MadsRudolph/curtain-drive/enclosure/showcase/drive-motion-poster.png

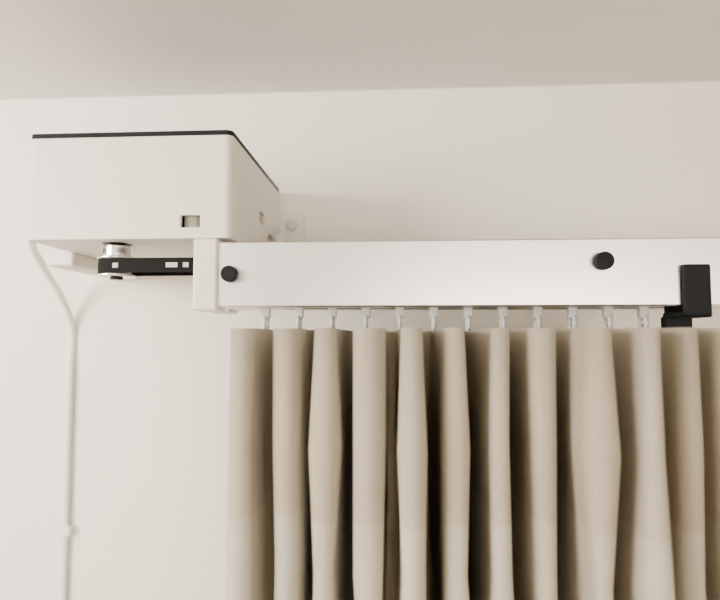
enclosure/showcase/drive-motion-poster.png
