MadsRudolph/curtain-drive/enclosure/showcase/curtains-motion-poster.png

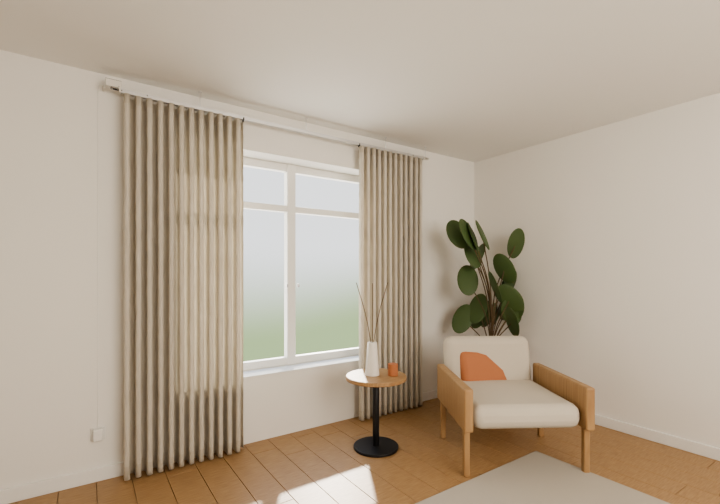
enclosure/showcase/curtains-motion-poster.png
