MadsRudolph/curtain-drive/enclosure/pulley/renders/clamp.png

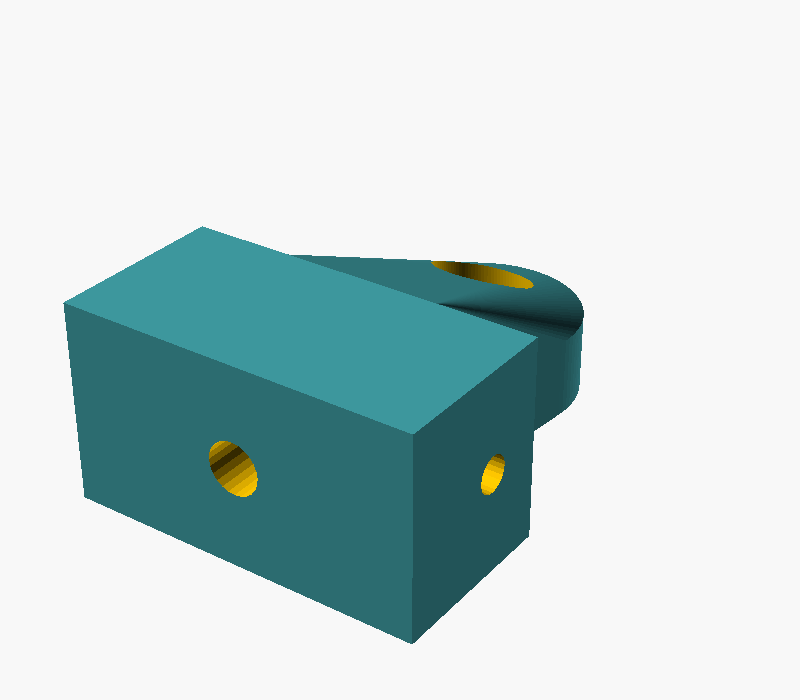
enclosure/pulley/renders/clamp.png
