MadsRudolph/curtain-drive/enclosure/pulley/renders/drum.png

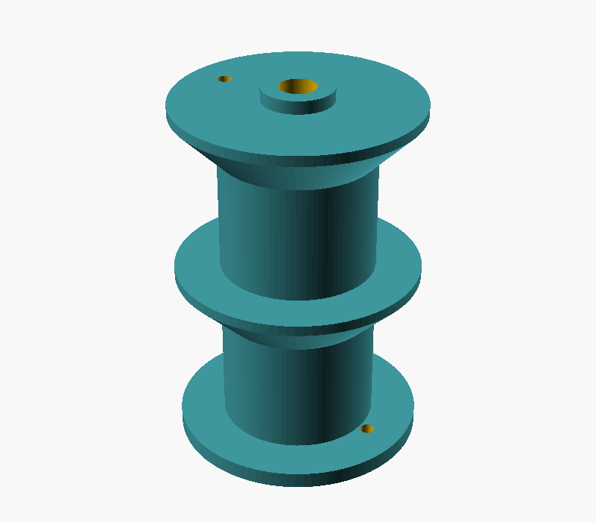
enclosure/pulley/renders/drum.png
