MadsRudolph/curtain-drive/enclosure/pulley/renders/drum_section.png

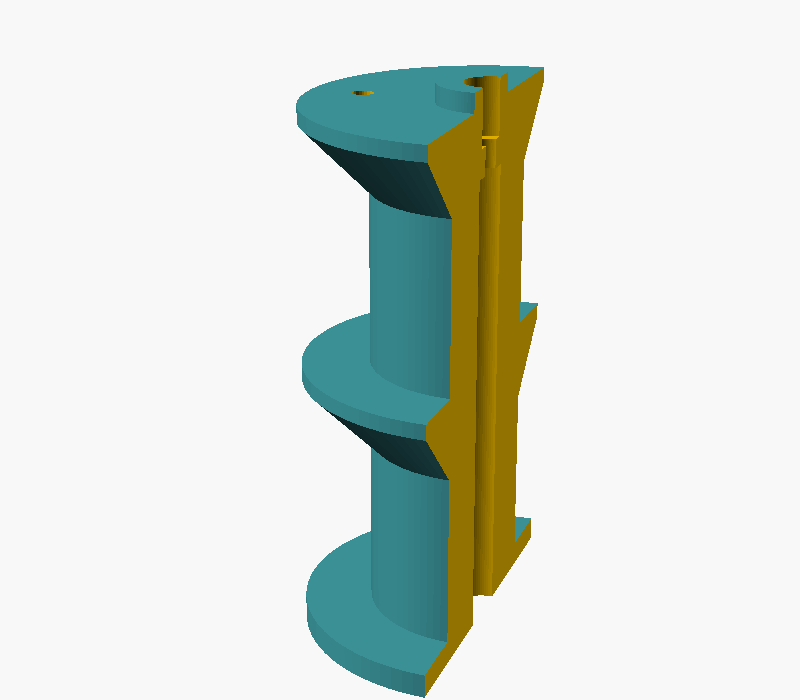
enclosure/pulley/renders/drum_section.png
