MadsRudolph/curtain-drive/enclosure/pulley/renders/idler_bracket.png

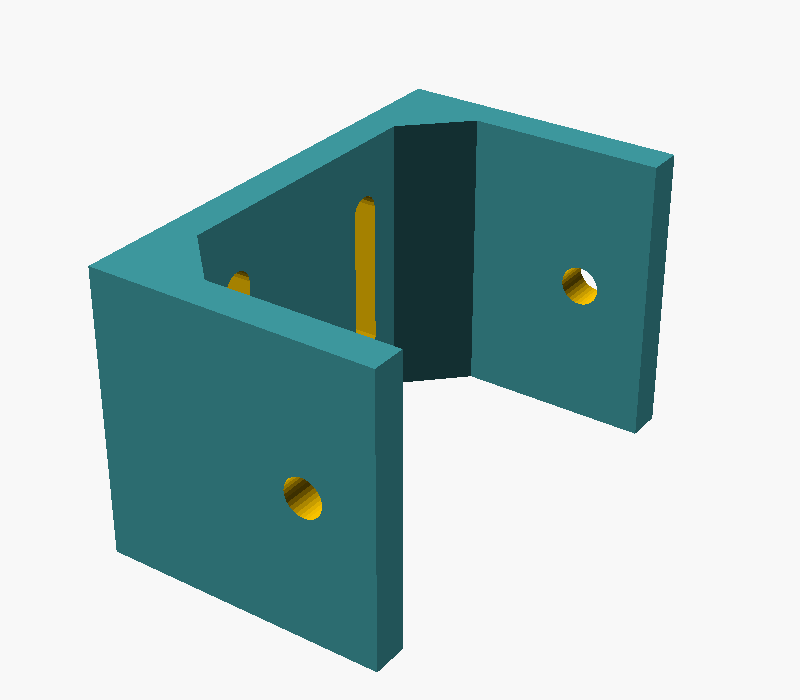
enclosure/pulley/renders/idler_bracket.png
