MadsRudolph/curtain-drive/enclosure/pulley/renders/overview.png

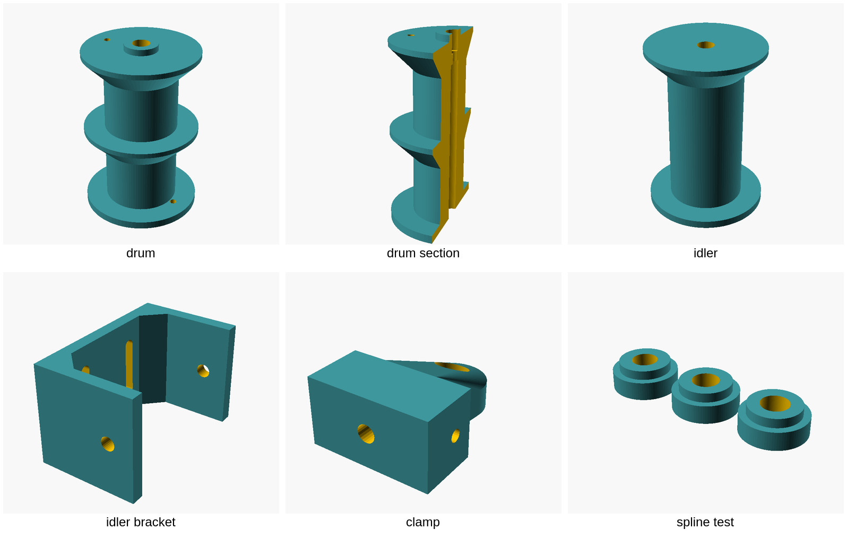
enclosure/pulley/renders/overview.png
