MadsRudolph/curtain-drive/enclosure/pulley/renders/plate_xl.png

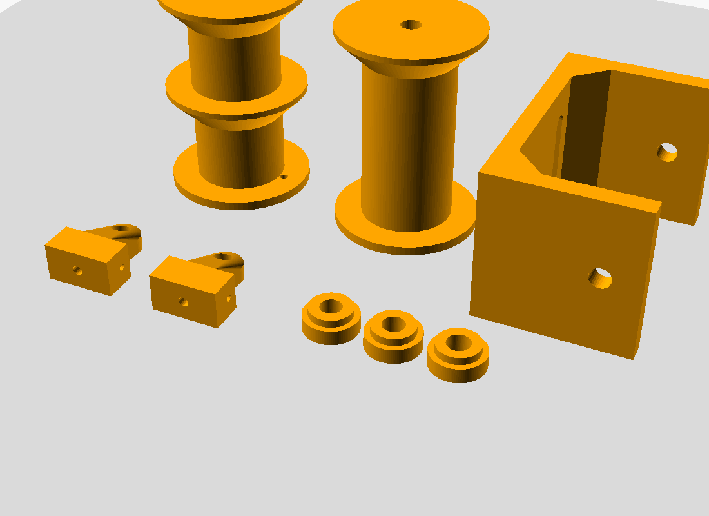
enclosure/pulley/renders/plate_xl.png
