MadsRudolph/curtain-drive/enclosure/renders/base_bottom.png

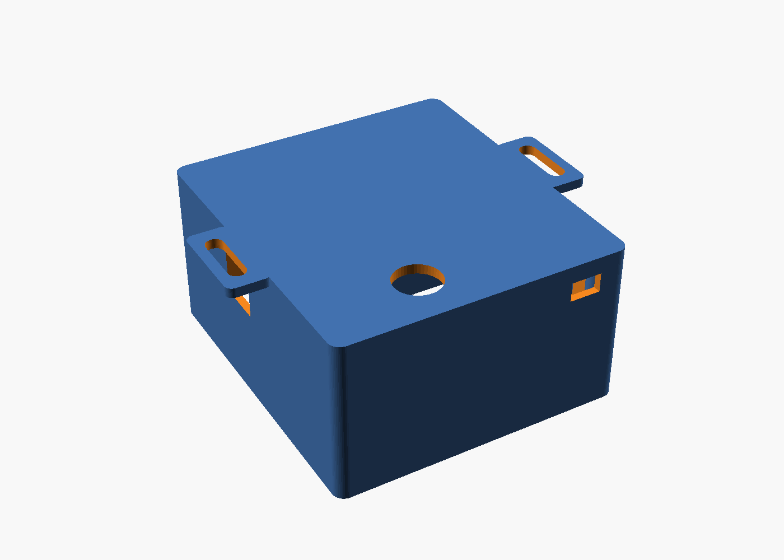
enclosure/renders/base_bottom.png
