MadsRudolph/curtain-drive/enclosure/renders/base_top.png

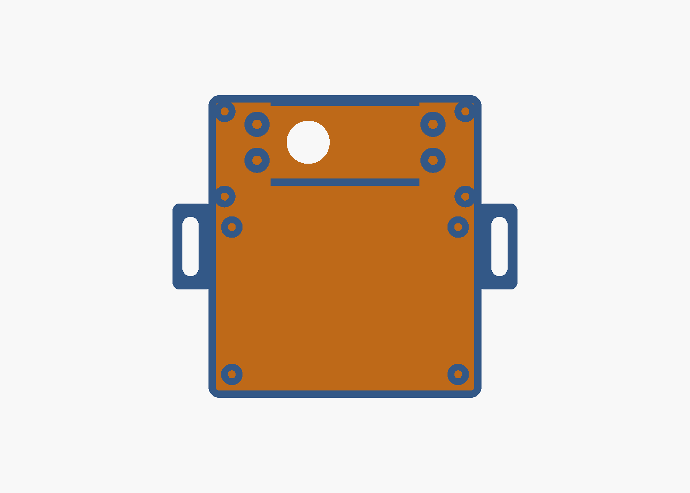
enclosure/renders/base_top.png
