MadsRudolph/curtain-drive/enclosure/renders/blender_closed.png

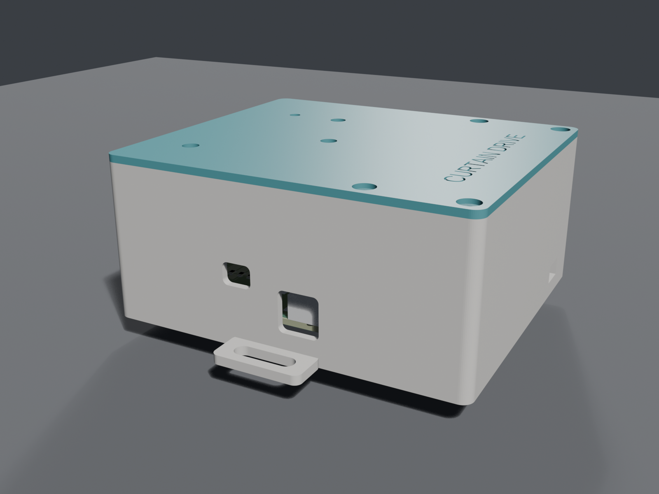
enclosure/renders/blender_closed.png
