MadsRudolph/curtain-drive/enclosure/renders/blender_open.png

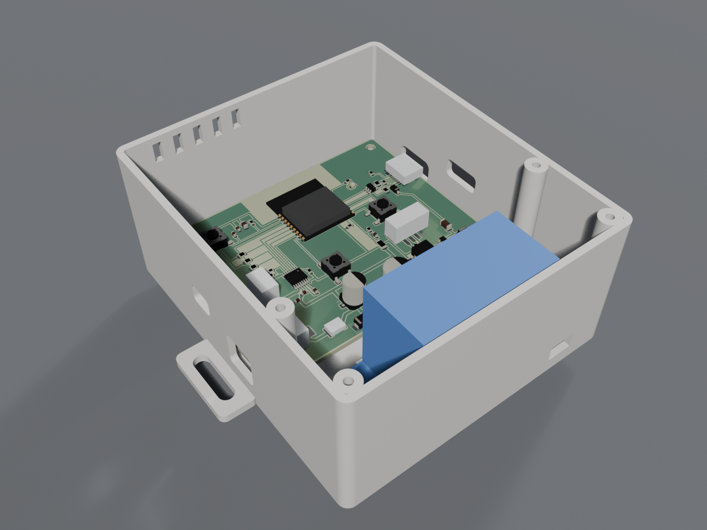
enclosure/renders/blender_open.png
