MadsRudolph/curtain-drive/enclosure/renders/lid.png

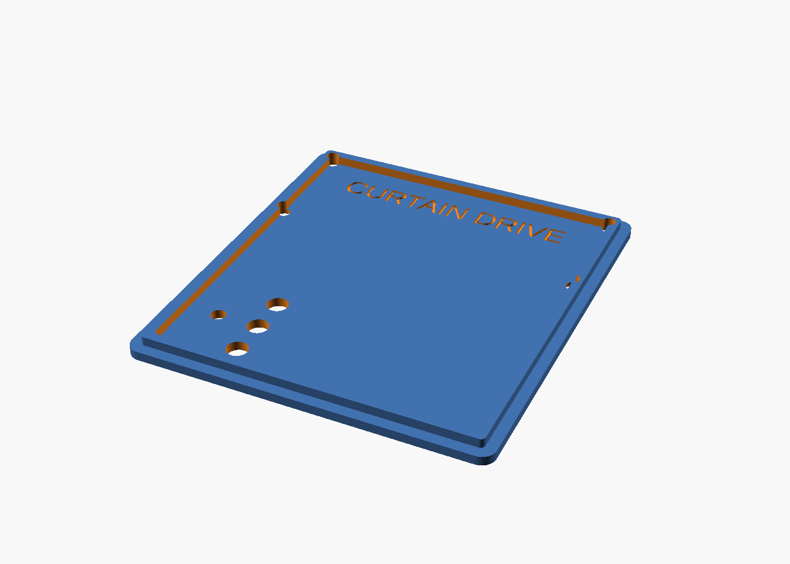
enclosure/renders/lid.png
