MadsRudolph/curtain-drive/enclosure/renders/pcb_iso.png

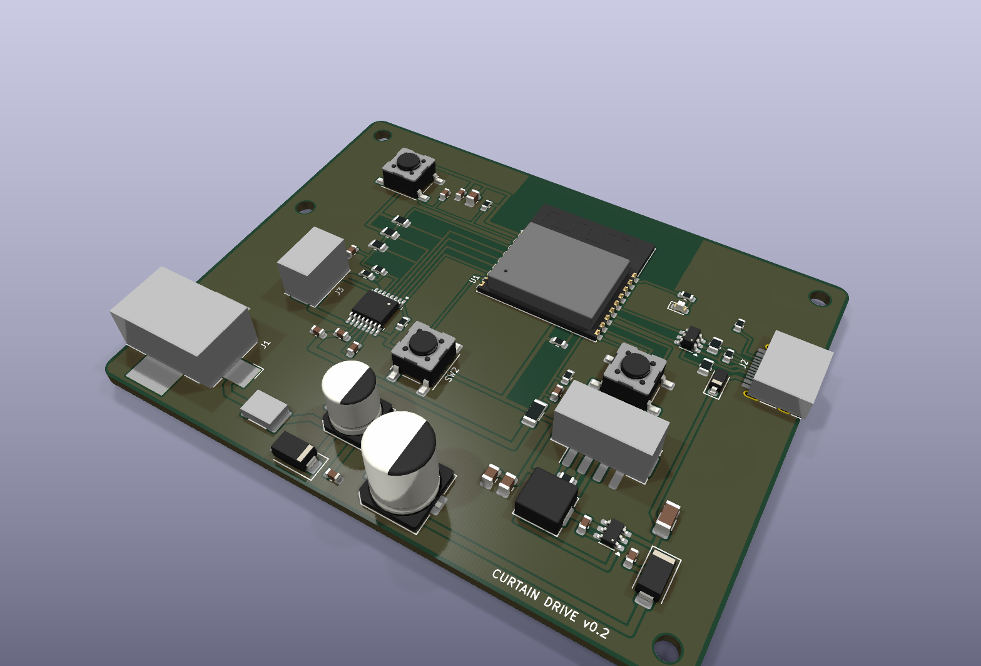
enclosure/renders/pcb_iso.png
