MadsRudolph/curtain-drive/enclosure/renders/pcb_revB_bottom.png

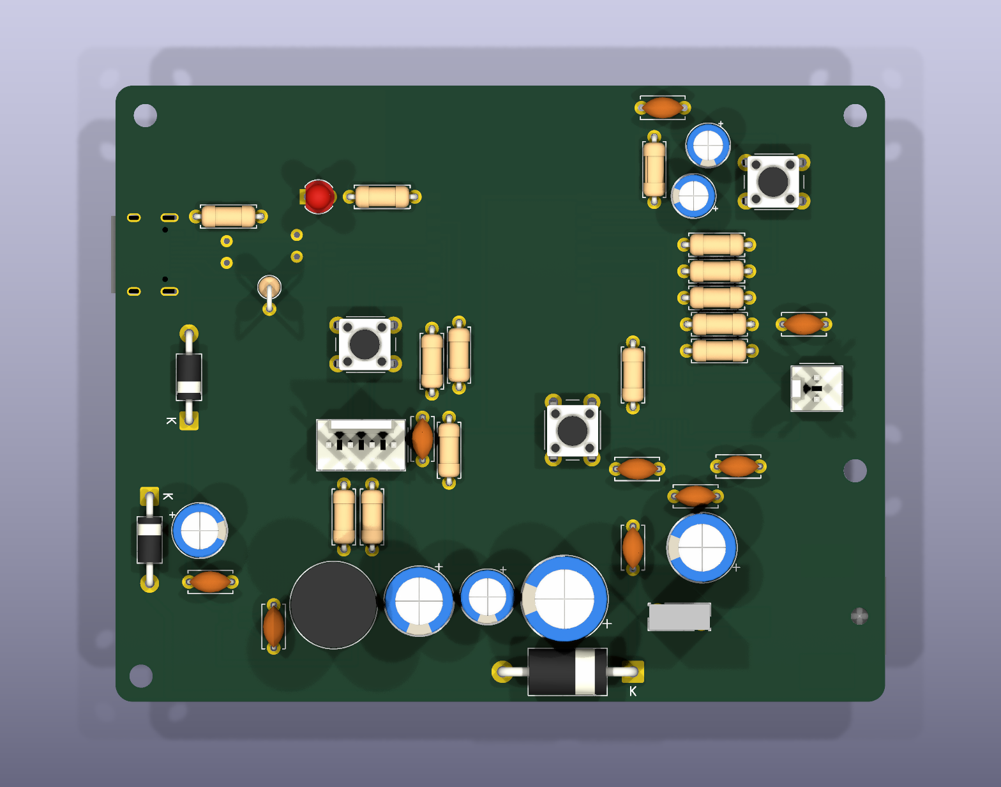
enclosure/renders/pcb_revB_bottom.png
