MadsRudolph/curtain-drive/enclosure/renders/pcb_revB_bottom_iso.png

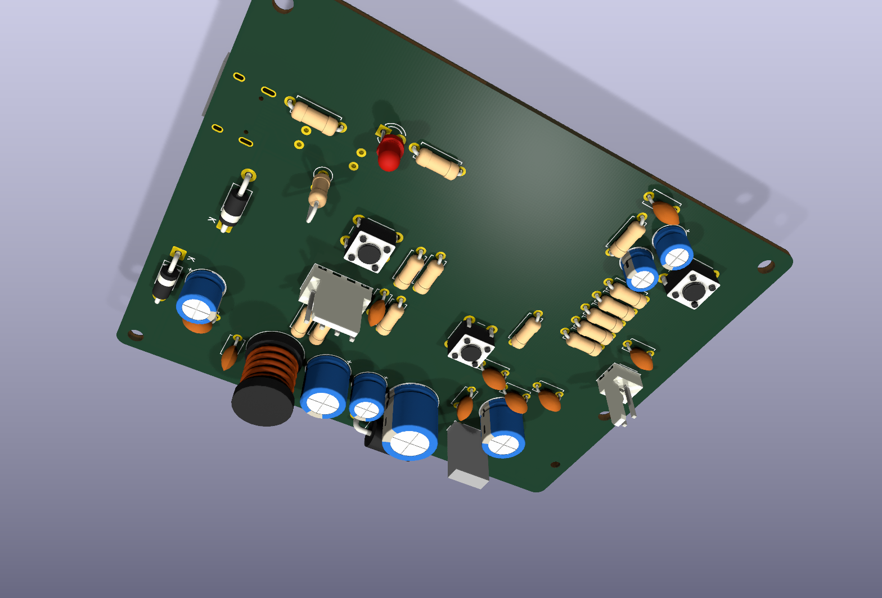
enclosure/renders/pcb_revB_bottom_iso.png
