MadsRudolph/curtain-drive/enclosure/renders/pcb_revB_iso.png

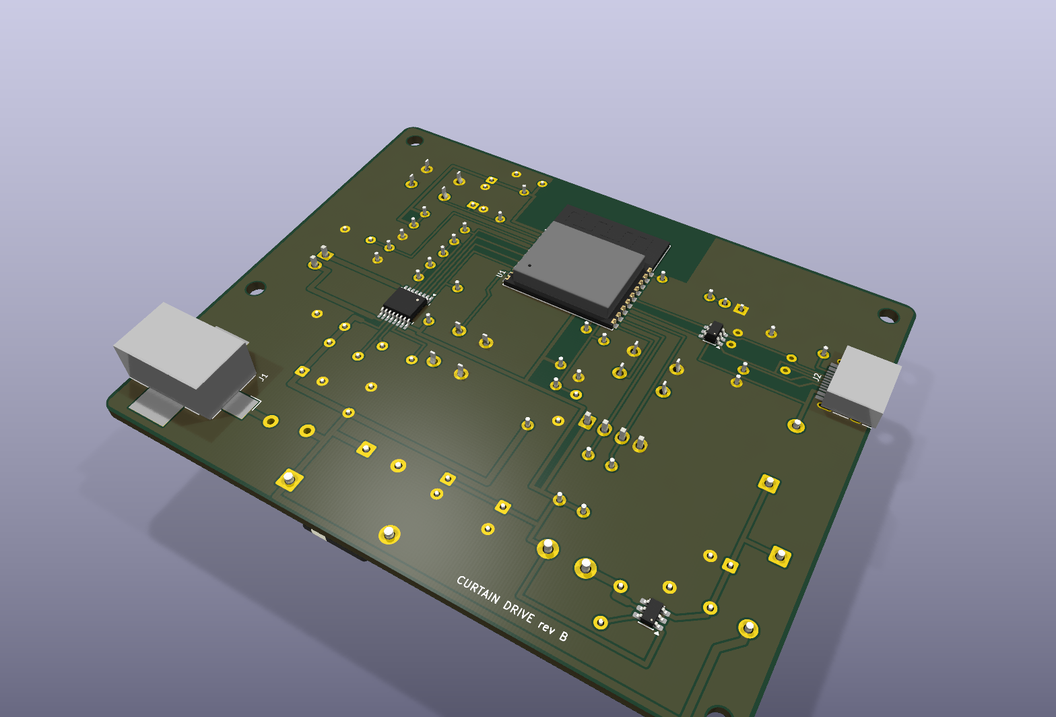
enclosure/renders/pcb_revB_iso.png
