MadsRudolph/curtain-drive/enclosure/renders/pcb_revB_top.png

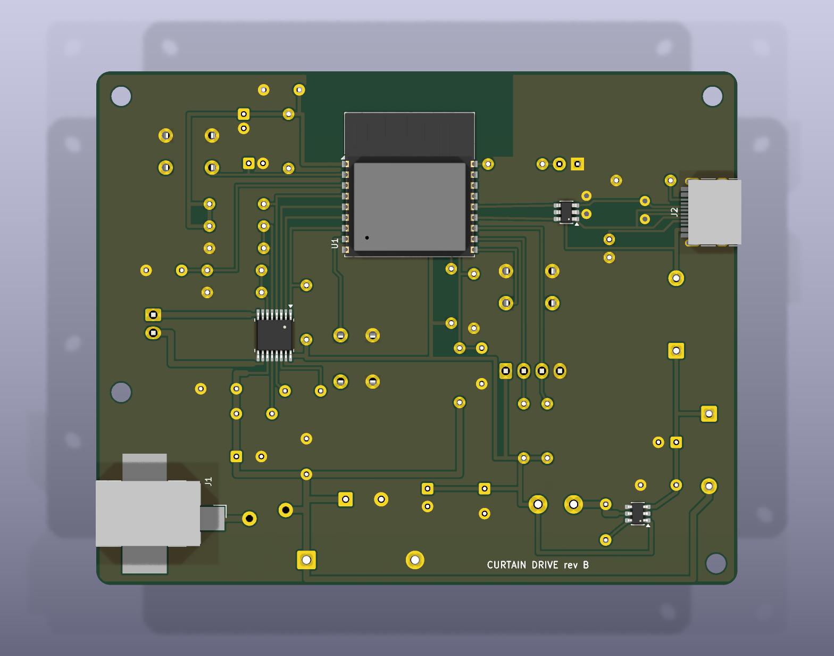
enclosure/renders/pcb_revB_top.png
