MadsRudolph/curtain-drive/enclosure/renders/pcb_top.png

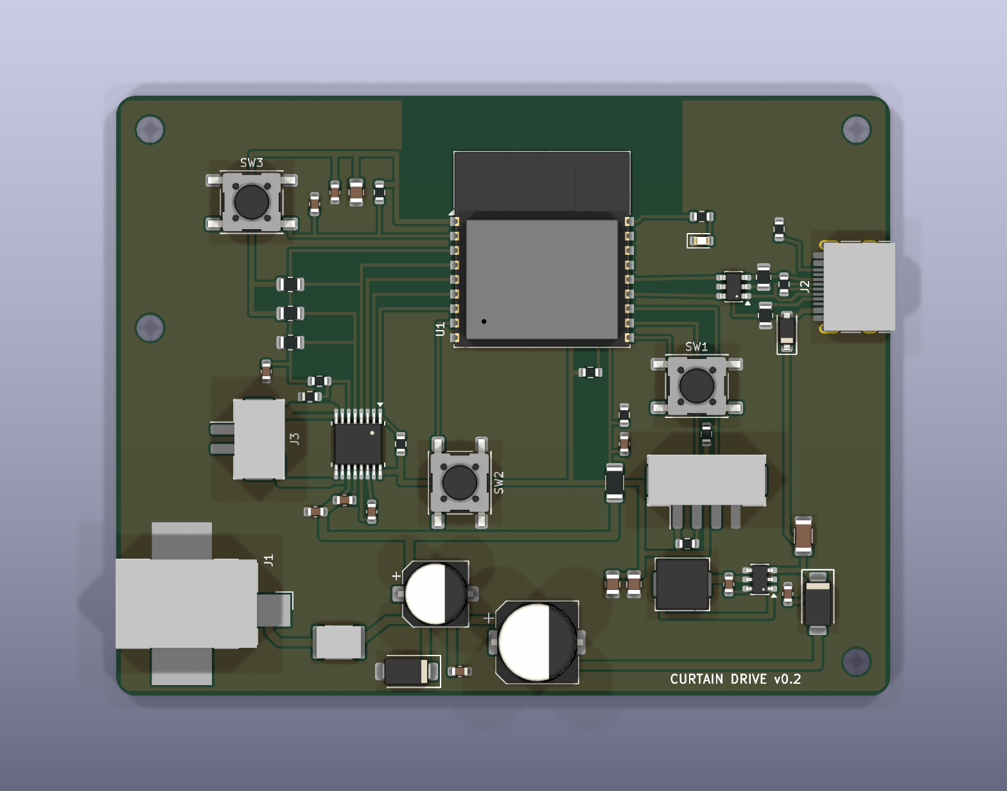
enclosure/renders/pcb_top.png
