MadsRudolph/curtain-drive/enclosure/renders/revC_closed.png

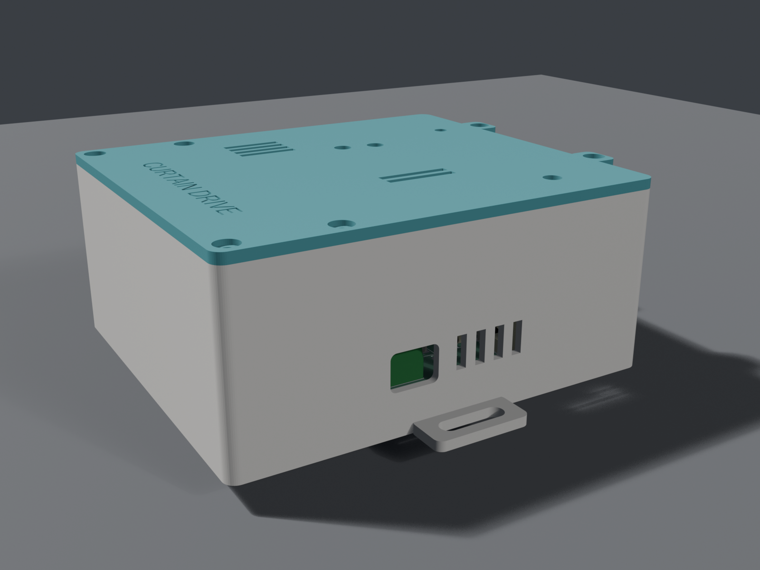
enclosure/renders/revC_closed.png
