MadsRudolph/curtain-drive/enclosure/renders/revC_lid_underside.png

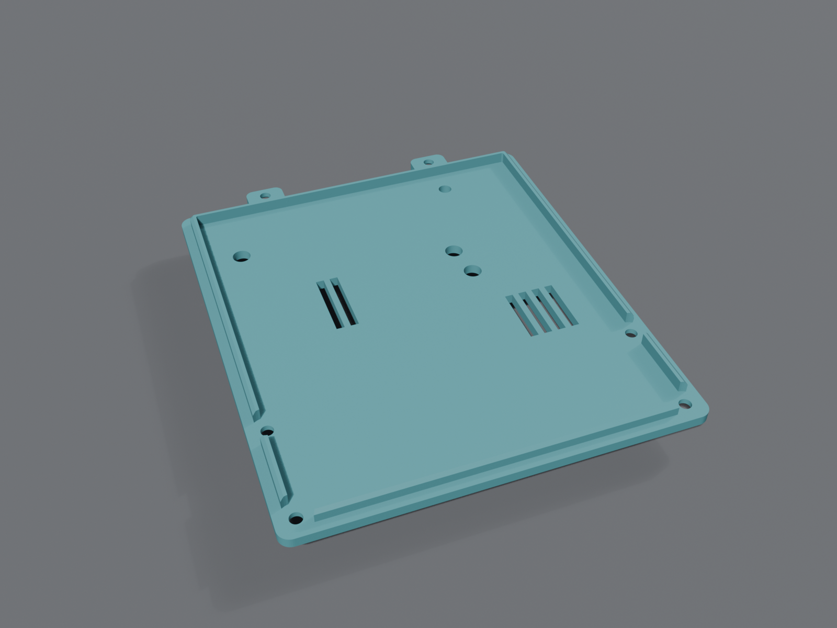
enclosure/renders/revC_lid_underside.png
