MadsRudolph/curtain-drive/enclosure/renders/revC_open.png

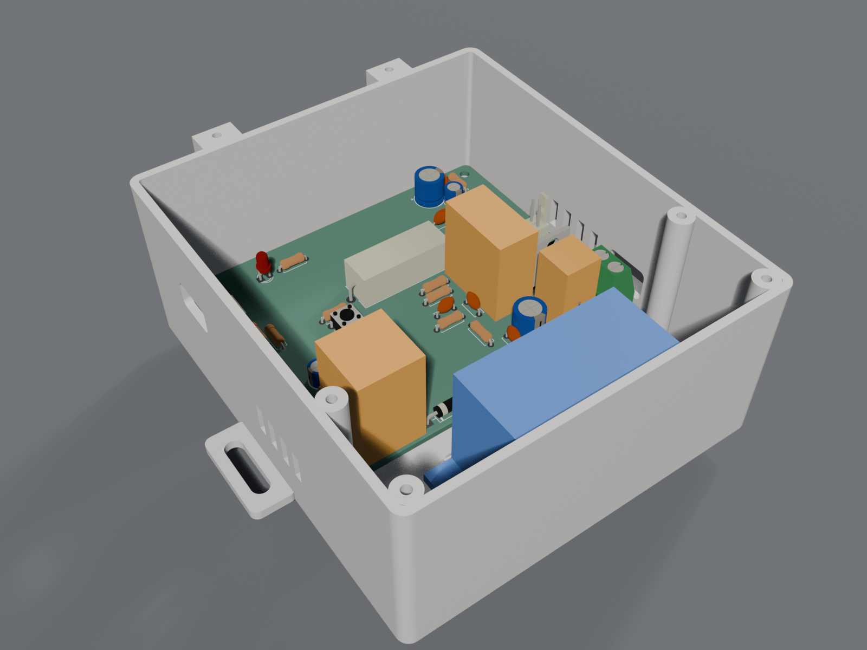
enclosure/renders/revC_open.png
