MadsRudolph/curtain-drive/enclosure/showcase/curtains-motion.gif

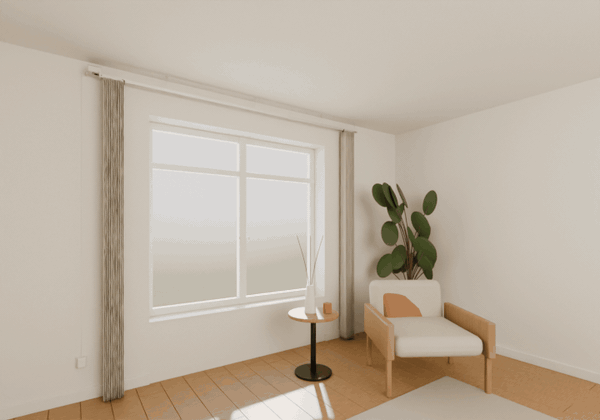
enclosure/showcase/curtains-motion.gif
