MadsRudolph/curtain-drive/enclosure/showcase/drive-closeup.png

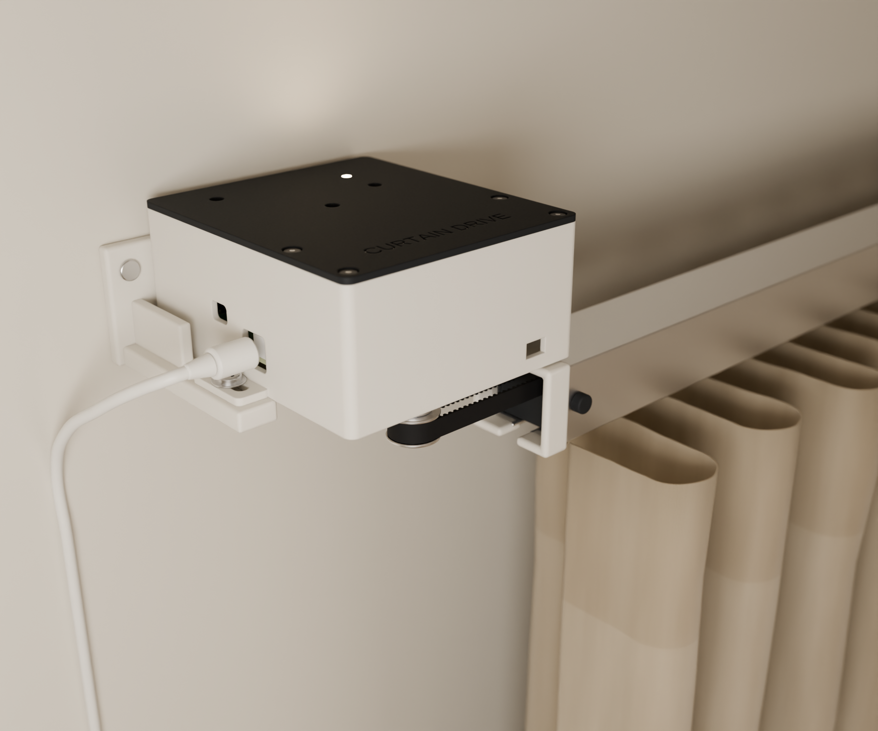
enclosure/showcase/drive-closeup.png
