MadsRudolph/curtain-drive/enclosure/showcase/drive-motion.gif

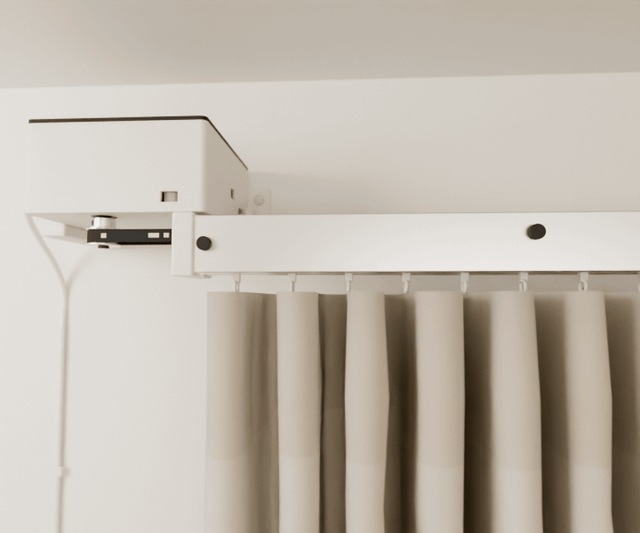
enclosure/showcase/drive-motion.gif
