MadsRudolph/curtain-drive/enclosure/showcase/hero.png

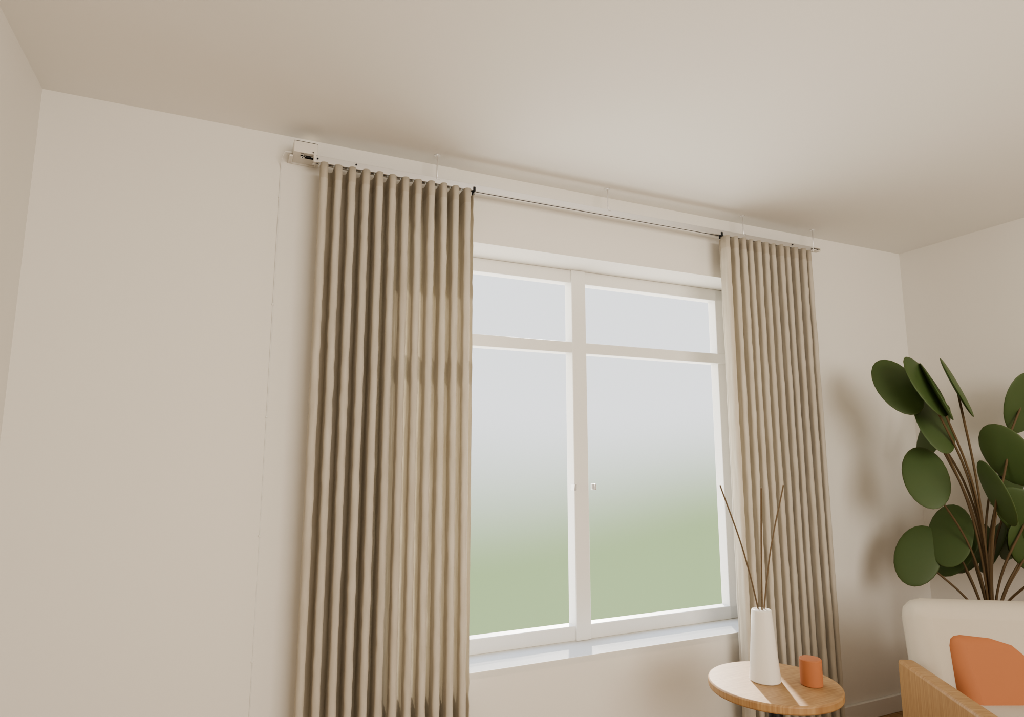
enclosure/showcase/hero.png
