MadsRudolph/curtain-drive/enclosure/showcase/inside.png

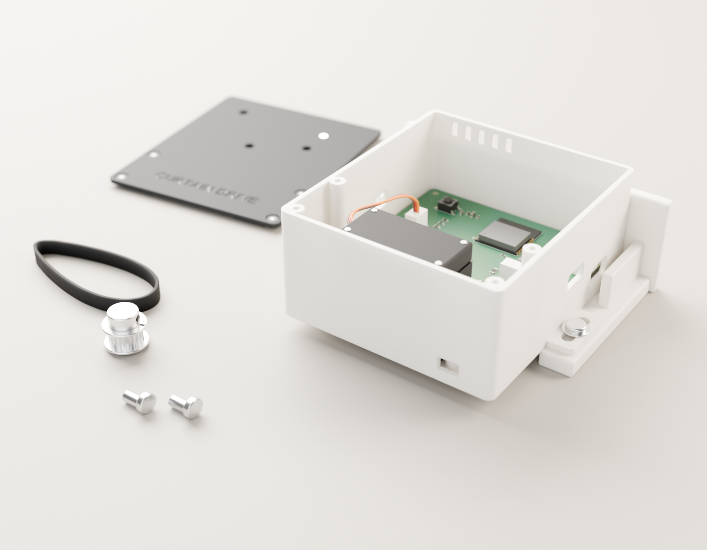
enclosure/showcase/inside.png
