MadsRudolph/curtain-drive/hardware-revC/production/laser/curtain-drive-revC-preview.png

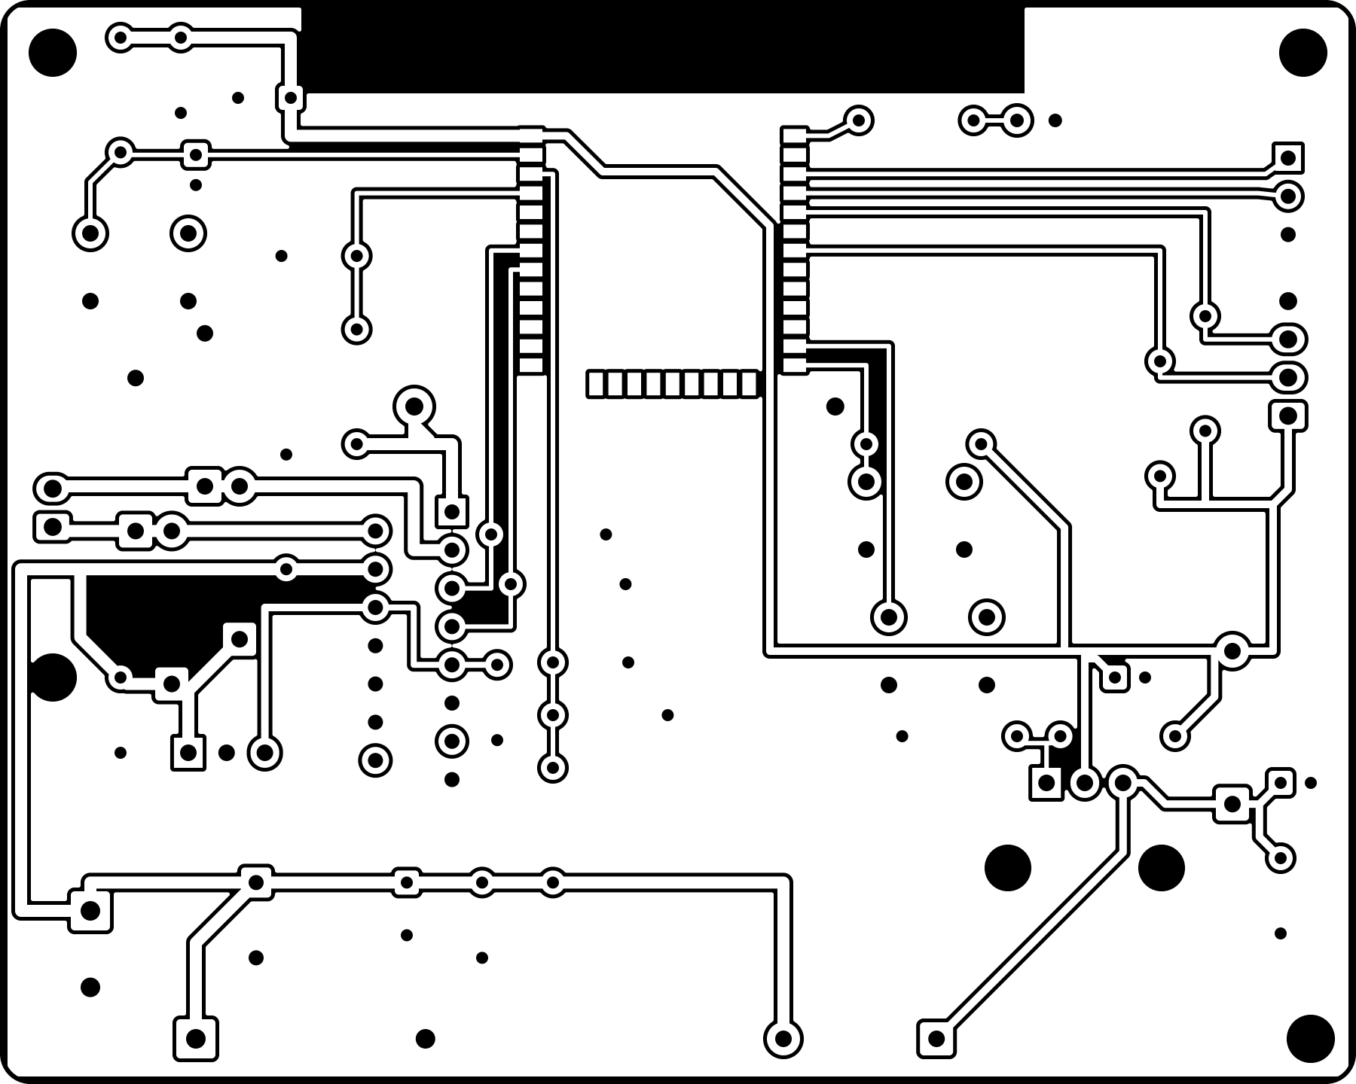
hardware-revC/production/laser/curtain-drive-revC-preview.png
