MadsRudolph/curtain-drive/hardware/production/laser/curtain-drive-preview.png

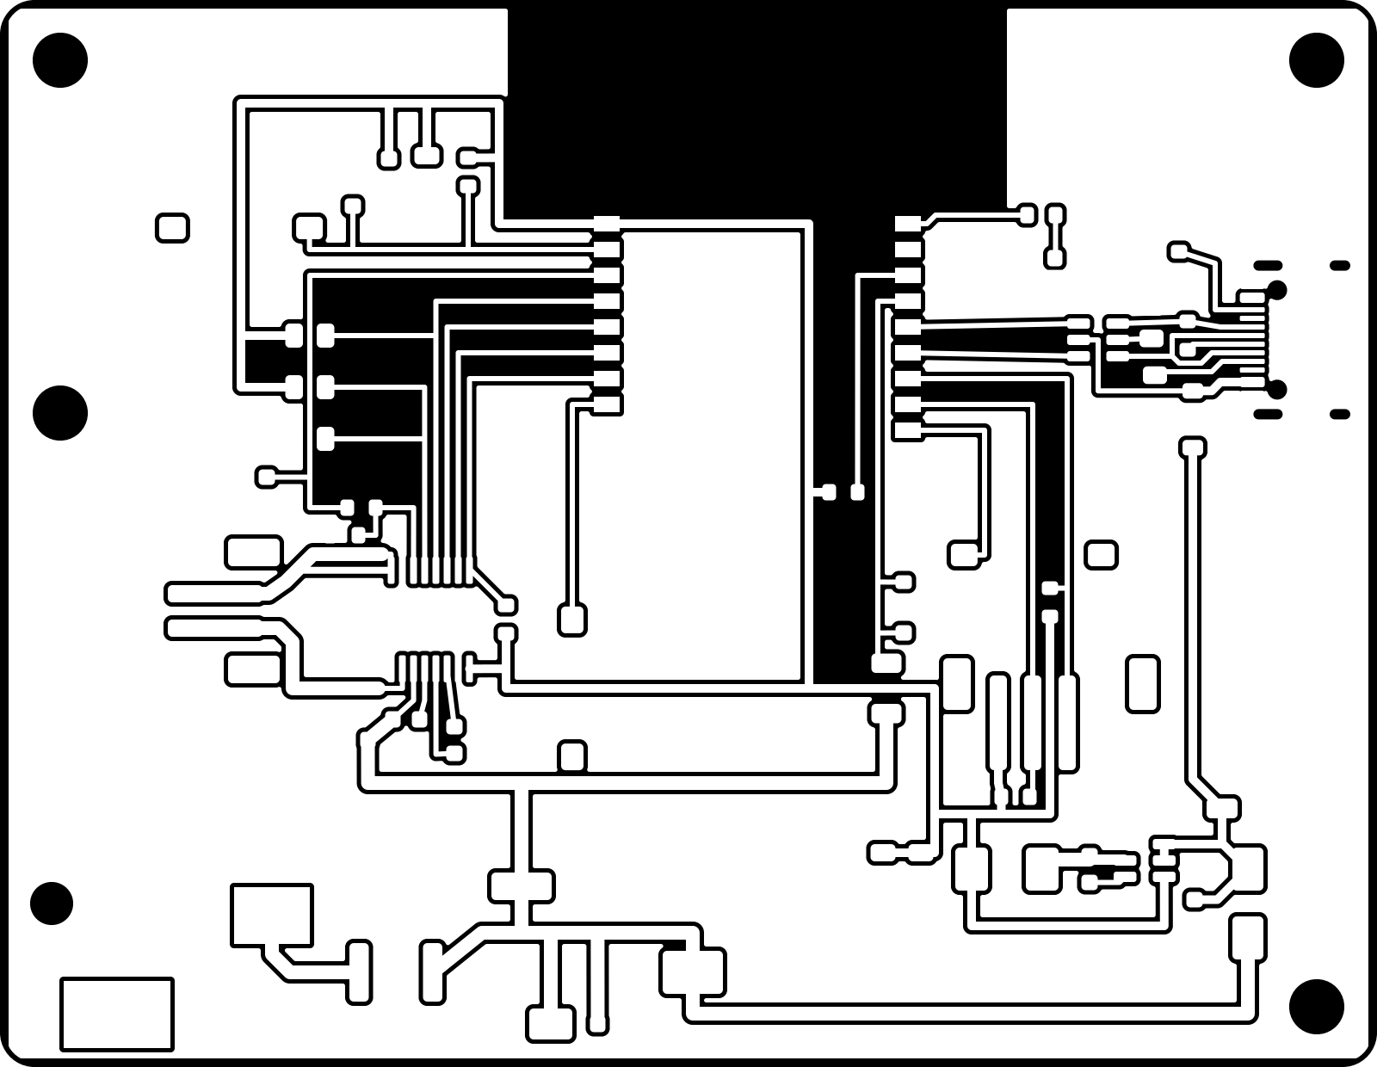
hardware/production/laser/curtain-drive-preview.png
