MadsRudolph/curtain-drive/enclosure/pcb3d/curtain-drive-pcb.step

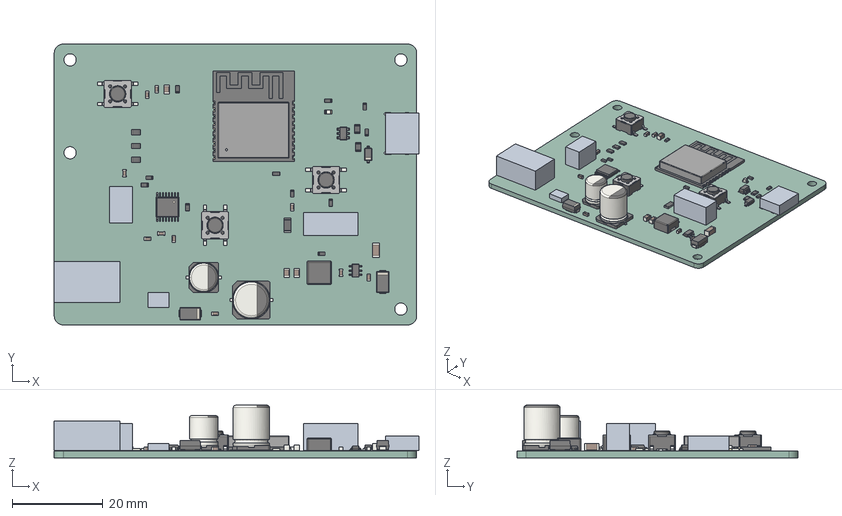
[picture p30: CAD file, 2026-09-26]
enclosure/pcb3d/curtain-drive-pcb.step
80.5 x 62.0 x 11.6 mm
R_0805_2012Metric x 5
C_0603_1608Metric x 10
C_0805_2012Metric x 3
ESP32-C3-WROOM-02
R_0603_1608Metric x 11
a6ee02de-8551-11ed-a139-00155d22e2d7_part
a6ee040a-8551-11ed-a139-00155d22e2d7_part
a6ee048c-8551-11ed-a139-00155d22e2d7_part
R_1206_3216Metric
SW_SPST_PTS645Sx43SMTR92 x 3
D_SMA x 2
CP_Elec_63x77
SOT-23-6
CP_Elec_8x10
HTSSOP-16-1EP_4.4x5mm_P0.65mm_EP3.4x5mm
TSOT-23-6
LED_0603_1608Metric
D_SOD-123
C_1206_3216Metric
curtain-drive_PCB
