MadsRudolph/curtain-drive/enclosure/pulley/stl/drum.stl

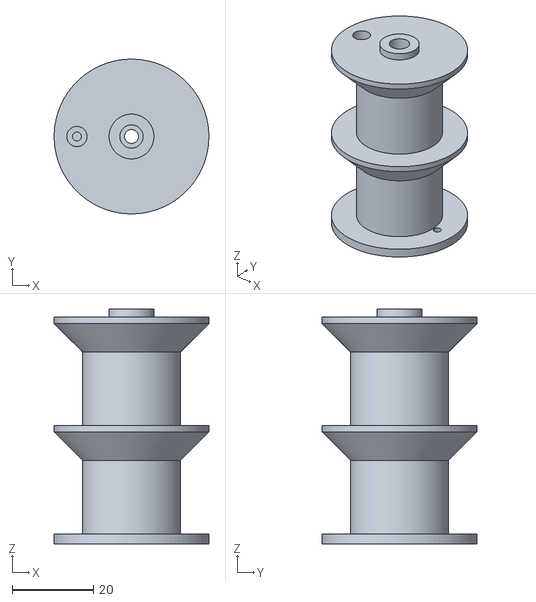
[picture p31: CAD file, 2026-10-02]
enclosure/pulley/stl/drum.stl
38.0 x 38.0 x 57.7
