MadsRudolph/curtain-drive/enclosure/stl/blender/curtain-drive-lid.stl

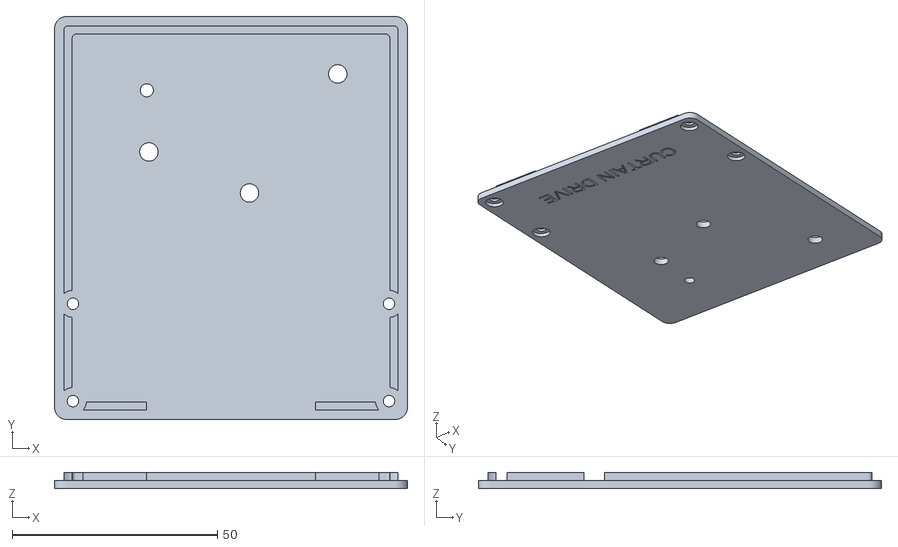
[picture p32: CAD file, 2026-09-26]
enclosure/stl/blender/curtain-drive-lid.stl
86.0 x 98.2 x 3.99
