MadsRudolph/curtain-drive/enclosure/stl/revC/curtain-drive-revC-lid.stl

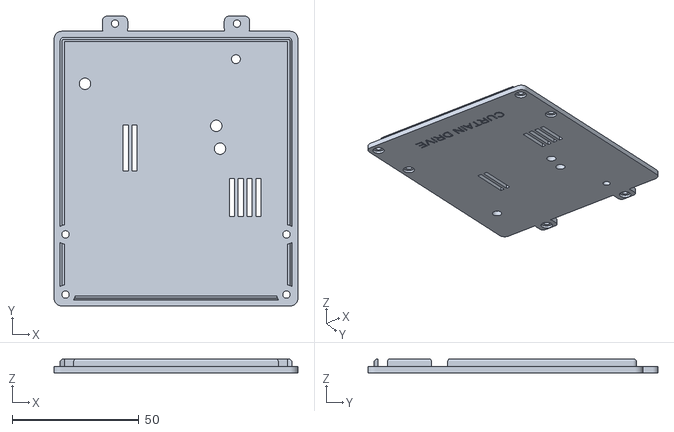
[picture p33: CAD file, 2026-09-28]
enclosure/stl/revC/curtain-drive-revC-lid.stl
96.0 x 114.2 x 5.50
