MadsRudolph/curtain-drive/hardware-revC/production/curtain-drive-revC-drl_map.dxf

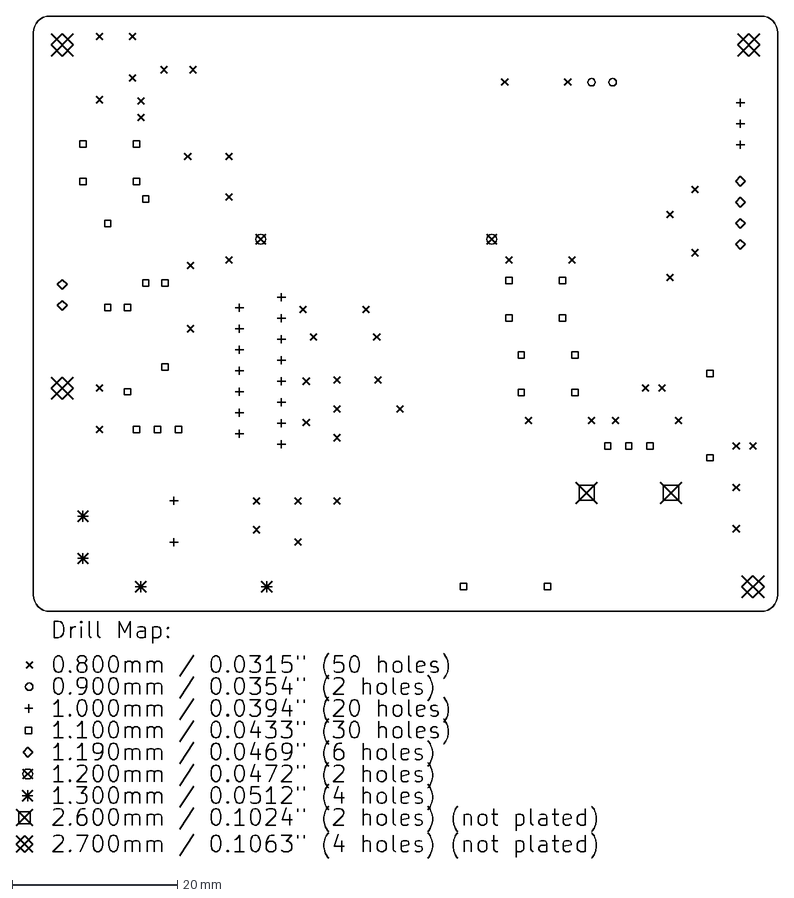
[picture p34: CAD file, 2026-09-26]
hardware-revC/production/curtain-drive-revC-drl_map.dxf
92.1 x 101.8 mm
