MadsRudolph/curtain-drive/hardware-revC/production/curtain-drive-revC-Edge_Cuts.dxf/curtain-drive-revC-Edge_Cuts.dxf

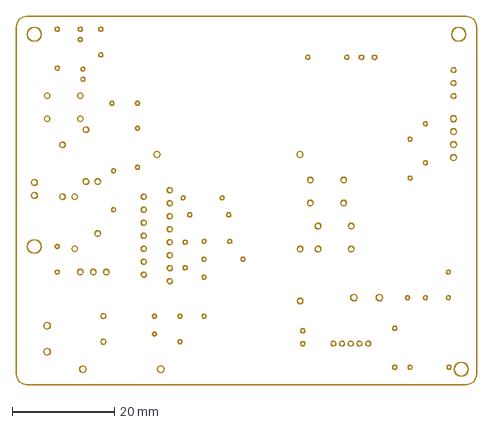
[picture p35: CAD file, 2026-09-26]
hardware-revC/production/curtain-drive-revC-Edge_Cuts.dxf/curtain-drive-revC-Edge_Cuts.dxf
90.0 x 72.0 mm
