MadsRudolph/curtain-drive/hardware-revC/production/laser/curtain-drive-revC-ablate.dxf

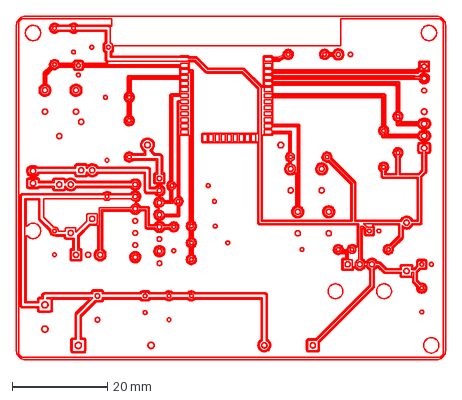
[picture p36: CAD file, 2026-09-26]
hardware-revC/production/laser/curtain-drive-revC-ablate.dxf
90.0 x 72.0 mm
