MadsRudolph/curtain-drive/hardware/production/curtain-drive-F_Cu.dxf

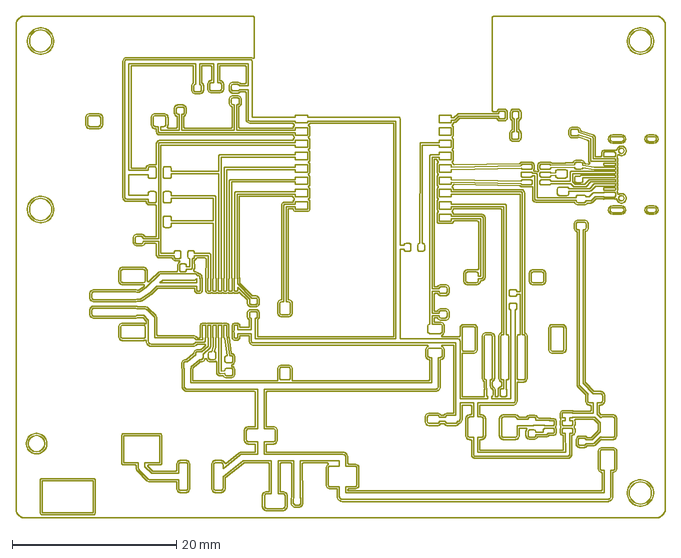
[picture p37: CAD file, 2026-09-26]
hardware/production/curtain-drive-F_Cu.dxf
79.0 x 61.0 mm
