MadsRudolph/curtain-drive/hardware/production/laser/curtain-drive-ablate.dxf

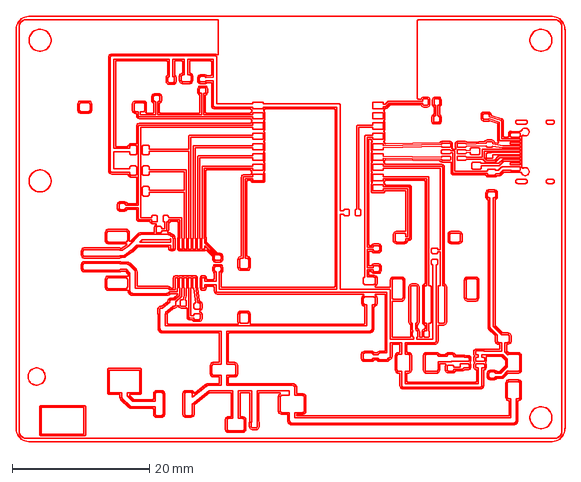
[picture p38: CAD file, 2026-09-26]
hardware/production/laser/curtain-drive-ablate.dxf
80.0 x 62.0 mm
