MadsRudolph/curtain-drive/enclosure/pcb3d/curtain-drive-revB-pcb.step

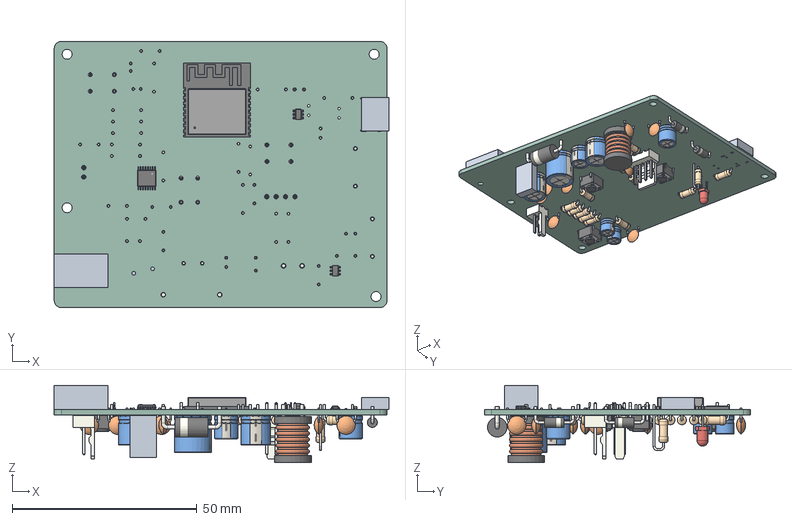
[picture p39: CAD file, 2026-09-26]
enclosure/pcb3d/curtain-drive-revB-pcb.step
90.5 x 72.0 x 20.9 mm
HTSSOP-16-1EP_4.4x5mm_P0.65mm_EP3.4x5mm
SOT-23-6
TSOT-23-6
ESP32-C3-WROOM-02
SW_PUSH_6mm x 3
D_DO-41_SOD81_P10.16mm_Horizontal x 2
CP_Radial_D80mm_P350mm x 2
C_Disc_D50mm_W25mm_P500mm x 9
L_Radial_D10.0mm_P5.00mm_Fastron_07M
R_Axial_DIN0207_L63mm_D25mm_P762mm_Horizontal x 14
R_Axial_DIN0207_L63mm_D25mm_P254mm_Vertical
CP_Radial_D63mm_P250mm x 2
CP_Radial_D50mm_P200mm x 2
CP_Radial_D100mm_P500mm
D_DO-201AE_P15.24mm_Horizontal
Molex_AE_6410_04A
LED_D3.0mm
Molex_AE_6410_02A
curtain-drive-revB_PCB
