MadsRudolph/curtain-drive/enclosure/pulley/stl/idler_bracket.stl

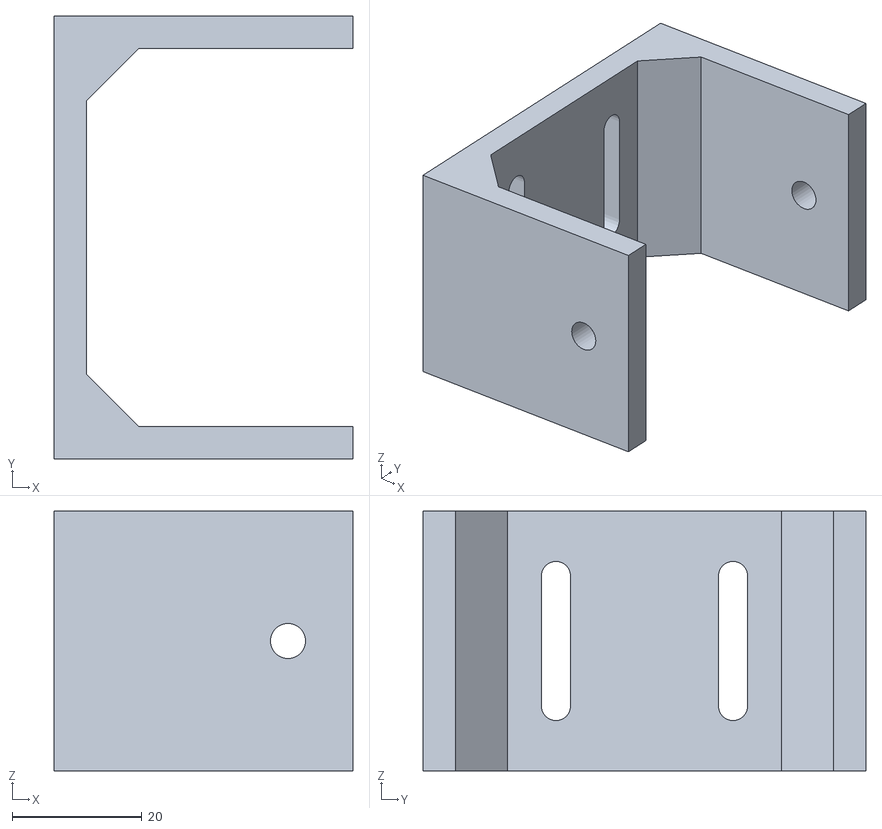
[picture p40: CAD file, 2026-10-02]
enclosure/pulley/stl/idler_bracket.stl
46.0 x 68.1 x 40.0
