MadsRudolph/curtain-drive/enclosure/stl/blender/curtain-drive-base.stl

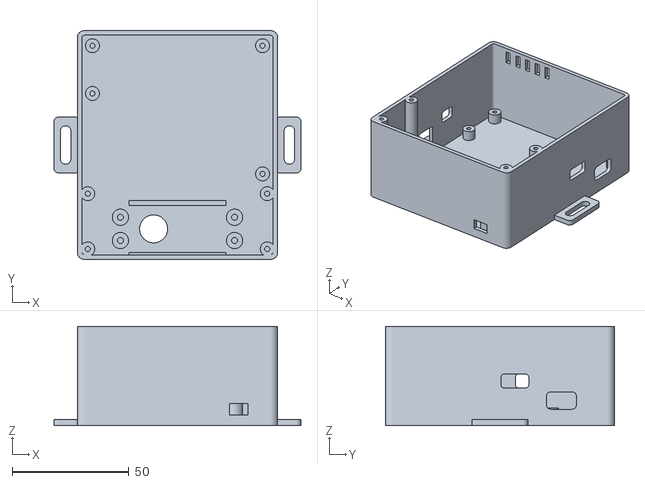
[picture p41: CAD file, 2026-09-26]
enclosure/stl/blender/curtain-drive-base.stl
106.0 x 98.2 x 42.5
