MadsRudolph/curtain-drive/enclosure/stl/revC/curtain-drive-revC-base.stl

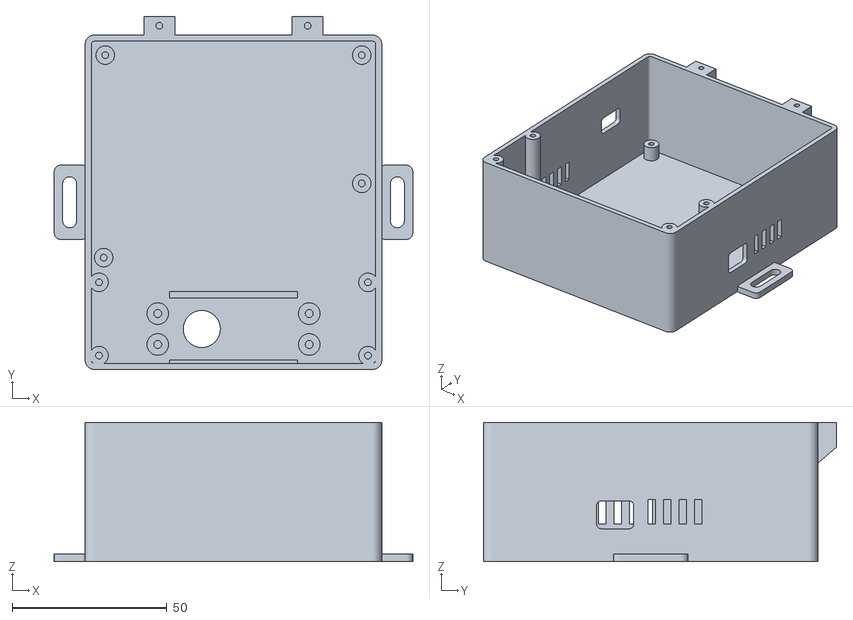
[picture p42: CAD file, 2026-09-28]
enclosure/stl/revC/curtain-drive-revC-base.stl
116.0 x 114.2 x 45.0
