MadsRudolph/curtain-drive/hardware-revC/production/laser/curtain-drive-revC-mask.dxf

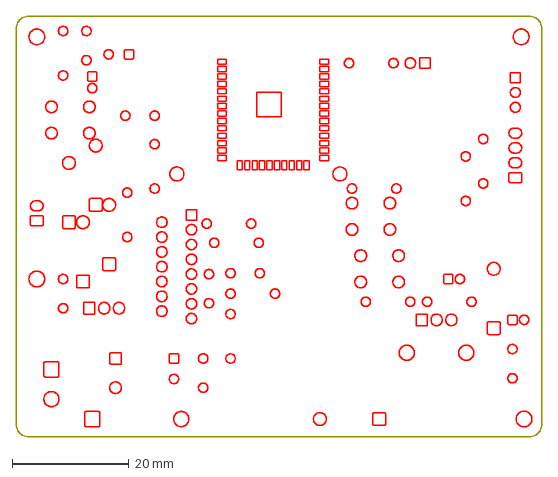
[picture p44: CAD file, 2026-09-26]
hardware-revC/production/laser/curtain-drive-revC-mask.dxf
90.0 x 72.0 mm
