MadsRudolph/curtain-drive/hardware/production/curtain-drive-drl_map.dxf

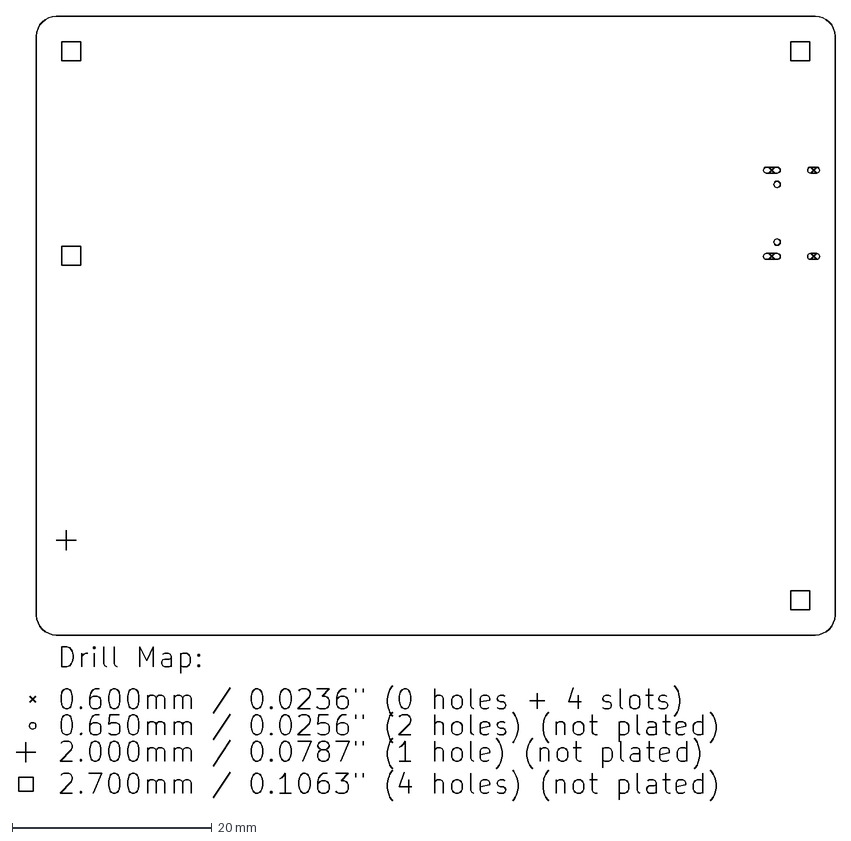
[picture p45: CAD file, 2026-09-26]
hardware/production/curtain-drive-drl_map.dxf
82.1 x 78.6 mm
