MadsRudolph/curtain-drive/hardware/production/laser/curtain-drive-mask.dxf

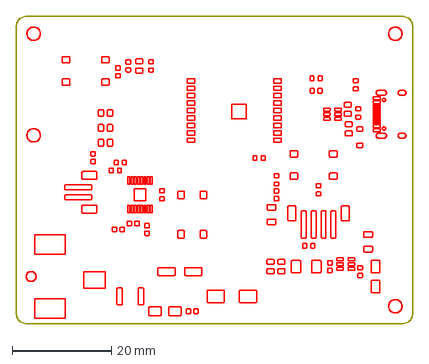
[picture p46: CAD file, 2026-09-26]
hardware/production/laser/curtain-drive-mask.dxf
80.0 x 62.0 mm
