MadsRudolph/curtain-drive/enclosure/pulley/stl/clamp.stl

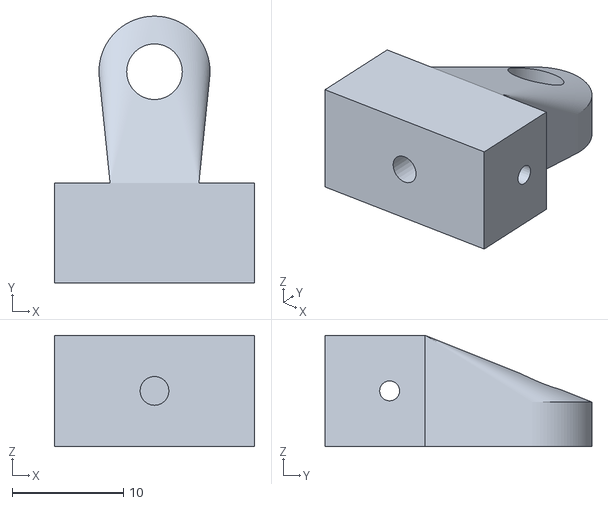
[picture p47: CAD file, 2026-09-28]
enclosure/pulley/stl/clamp.stl
18.0 x 24.0 x 10.0
