MadsRudolph/curtain-drive/hardware-revC/production/curtain-drive-revC-F_Cu.dxf

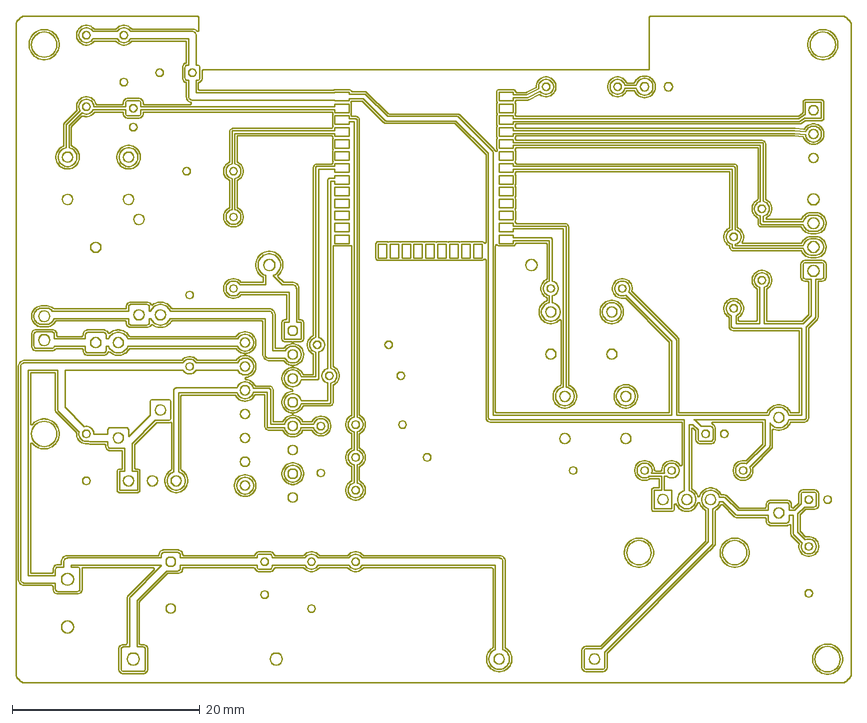
[picture p48: CAD file, 2026-09-26]
hardware-revC/production/curtain-drive-revC-F_Cu.dxf
89.0 x 71.0 mm
