MadsRudolph/curtain-drive/hardware-revC/production/laser/curtain-drive-revC-cut.dxf

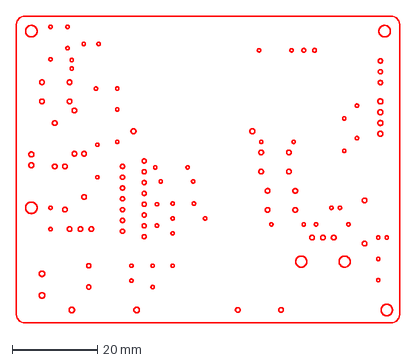
[picture p49: CAD file, 2026-09-26]
hardware-revC/production/laser/curtain-drive-revC-cut.dxf
90.0 x 72.0 mm
