MadsRudolph/curtain-drive/hardware/production/curtain-drive-Edge_Cuts.dxf

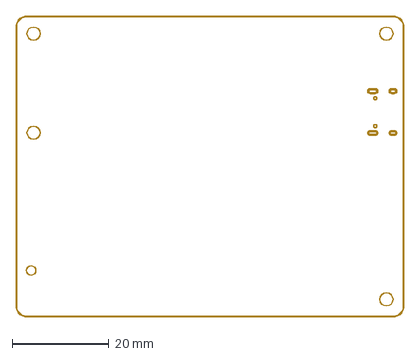
[picture p50: CAD file, 2026-09-26]
hardware/production/curtain-drive-Edge_Cuts.dxf
80.1 x 62.1 mm
