MadsRudolph/curtain-drive/hardware/production/laser/curtain-drive-cut.dxf

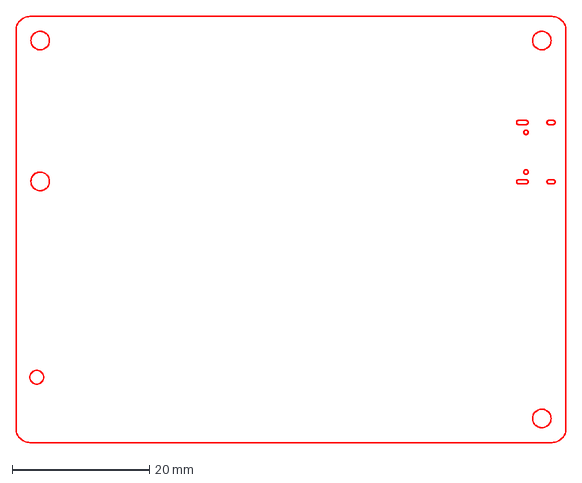
[picture p51: CAD file, 2026-09-26]
hardware/production/laser/curtain-drive-cut.dxf
80.0 x 62.0 mm
