MadsRudolph/curtain-drive/enclosure/pulley/stl/spline_test.stl

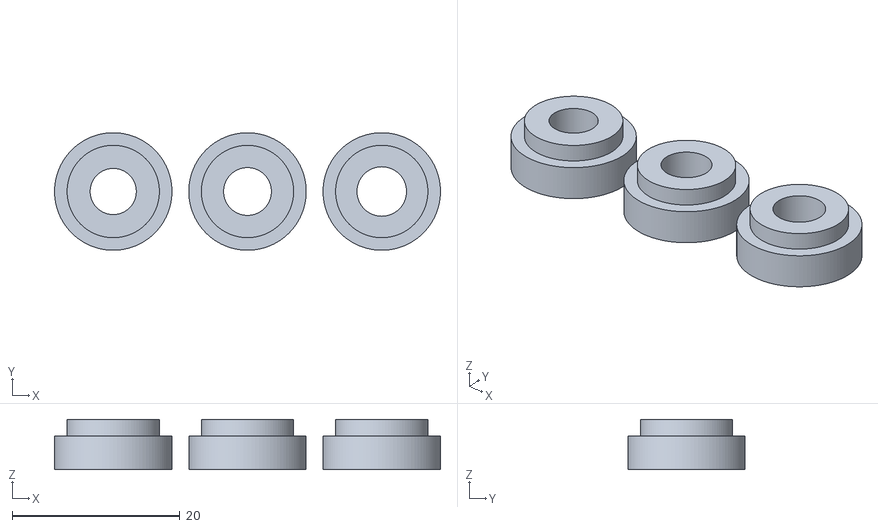
[picture p52: CAD file, 2026-09-28]
enclosure/pulley/stl/spline_test.stl
46.0 x 14.0 x 6.00
