MadsRudolph/curtain-drive/enclosure/pulley/stl/idler.stl

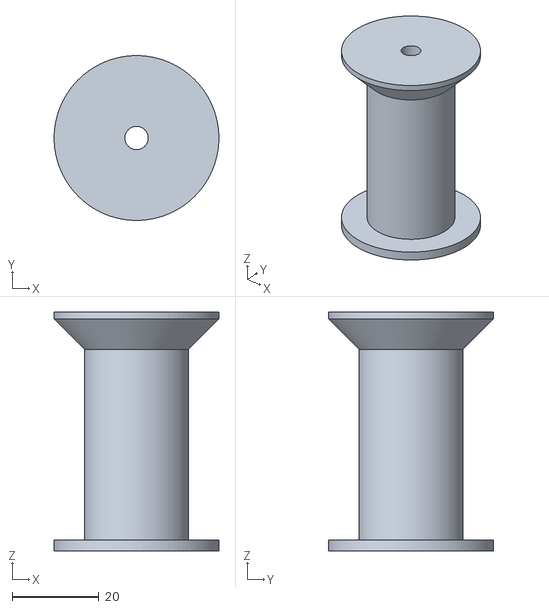
[picture p53: CAD file, 2026-09-28]
enclosure/pulley/stl/idler.stl
38.0 x 38.0 x 55.1
