MadsRudolph/curtain-drive/(list of files, cad)

Other CAD files:
enclosure/enclosure-revC.blend
enclosure/enclosure.blend
enclosure/showcase/curtain_showcase.blend
enclosure/stl/curtain-drive-base.stl
enclosure/stl/curtain-drive-lid.stl
hardware-revB/production/curtain-drive-revB-B_Silkscreen.dxf
hardware-revB/production/curtain-drive-revB-Edge_Cuts.dxf
hardware-revB/production/curtain-drive-revB-F_Cu.dxf
hardware-revB/production/curtain-drive-revB-F_Mask.dxf
hardware-revB/production/curtain-drive-revB-F_Silkscreen.dxf
hardware-revB/production/curtain-drive-revB-drl_map.dxf
hardware-revB/production/laser/curtain-drive-revB-ablate.dxf
hardware-revB/production/laser/curtain-drive-revB-cut.dxf
hardware-revB/production/laser/curtain-drive-revB-mask.dxf
hardware-revC/production/curtain-drive-revC-B_Silkscreen.dxf
hardware-revC/production/curtain-drive-revC-B_Silkscreen.dxf/curtain-drive-revC-B_Silkscreen.dxf
hardware-revC/production/curtain-drive-revC-F_Mask.dxf
hardware-revC/production/curtain-drive-revC-F_Silkscreen.dxf
hardware-revC/production/curtain-drive-revC-F_Silkscreen.dxf/curtain-drive-revC-F_Silkscreen.dxf
hardware/production/curtain-drive-F_Mask.dxf
hardware/production/curtain-drive-F_Silkscreen.dxf
