MadsRudolph/curtain-drive/enclosure/renders/assembly.png

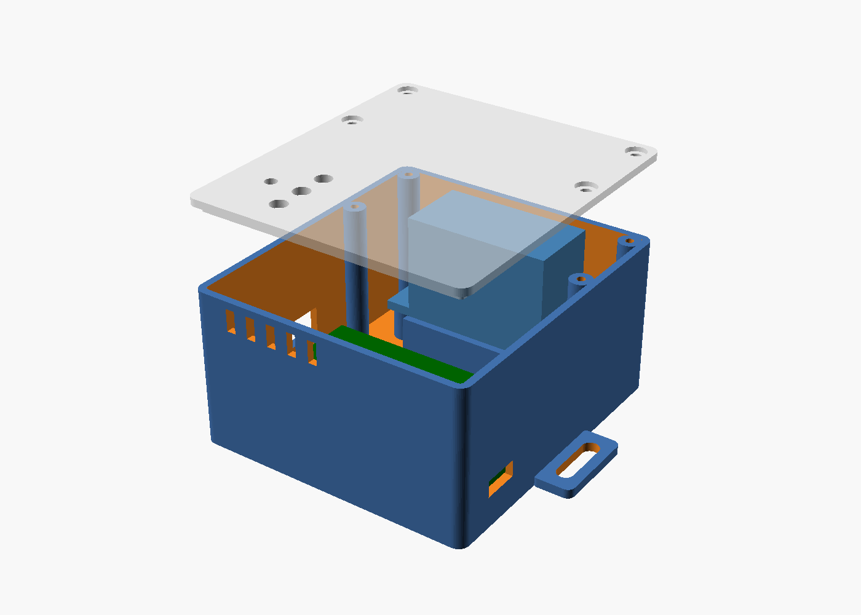
enclosure/renders/assembly.png
