MadsRudolph/curtain-drive/enclosure/renders/blender_assembly.png

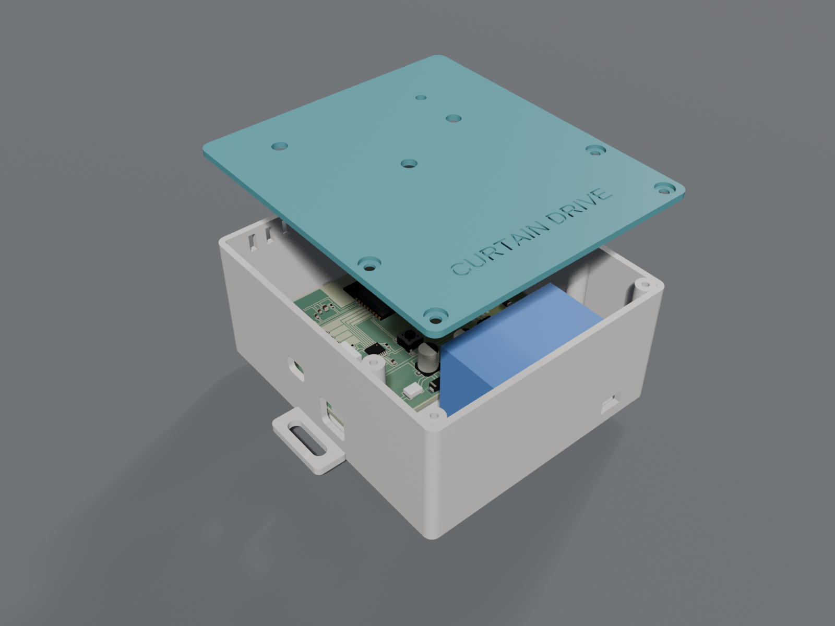
enclosure/renders/blender_assembly.png
