MadsRudolph/curtain-drive/enclosure/renders/revC_assembly.png

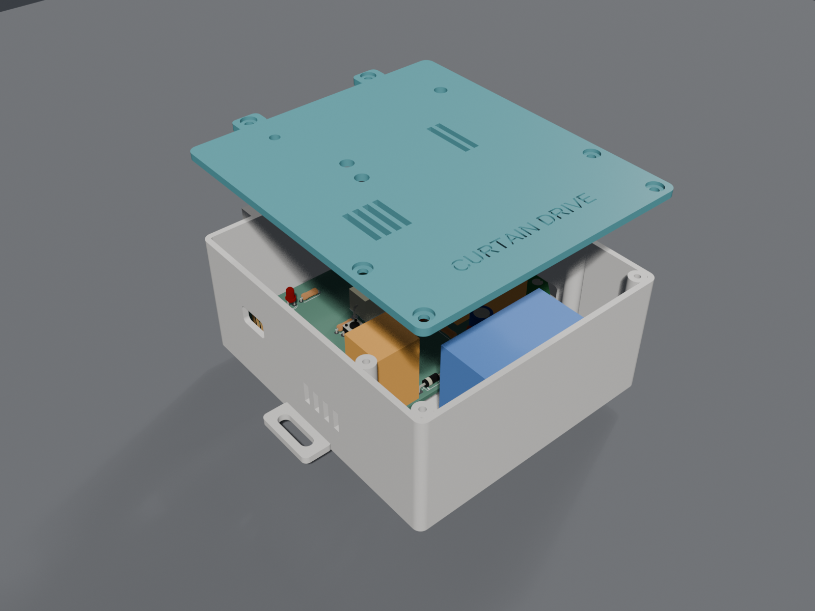
enclosure/renders/revC_assembly.png
