MadsRudolph/curtain-drive/enclosure/pulley/renders/spline_test.png

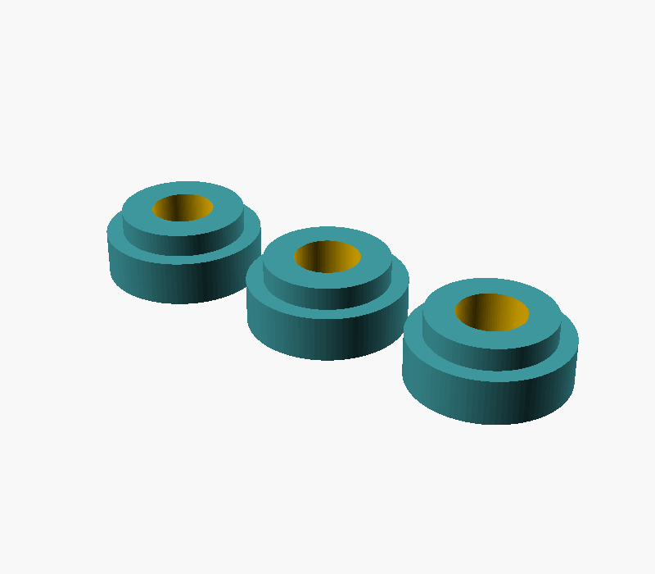
enclosure/pulley/renders/spline_test.png
