MadsRudolph/curtain-drive/hardware-revC/docs/curtain-drive-revC.pdf

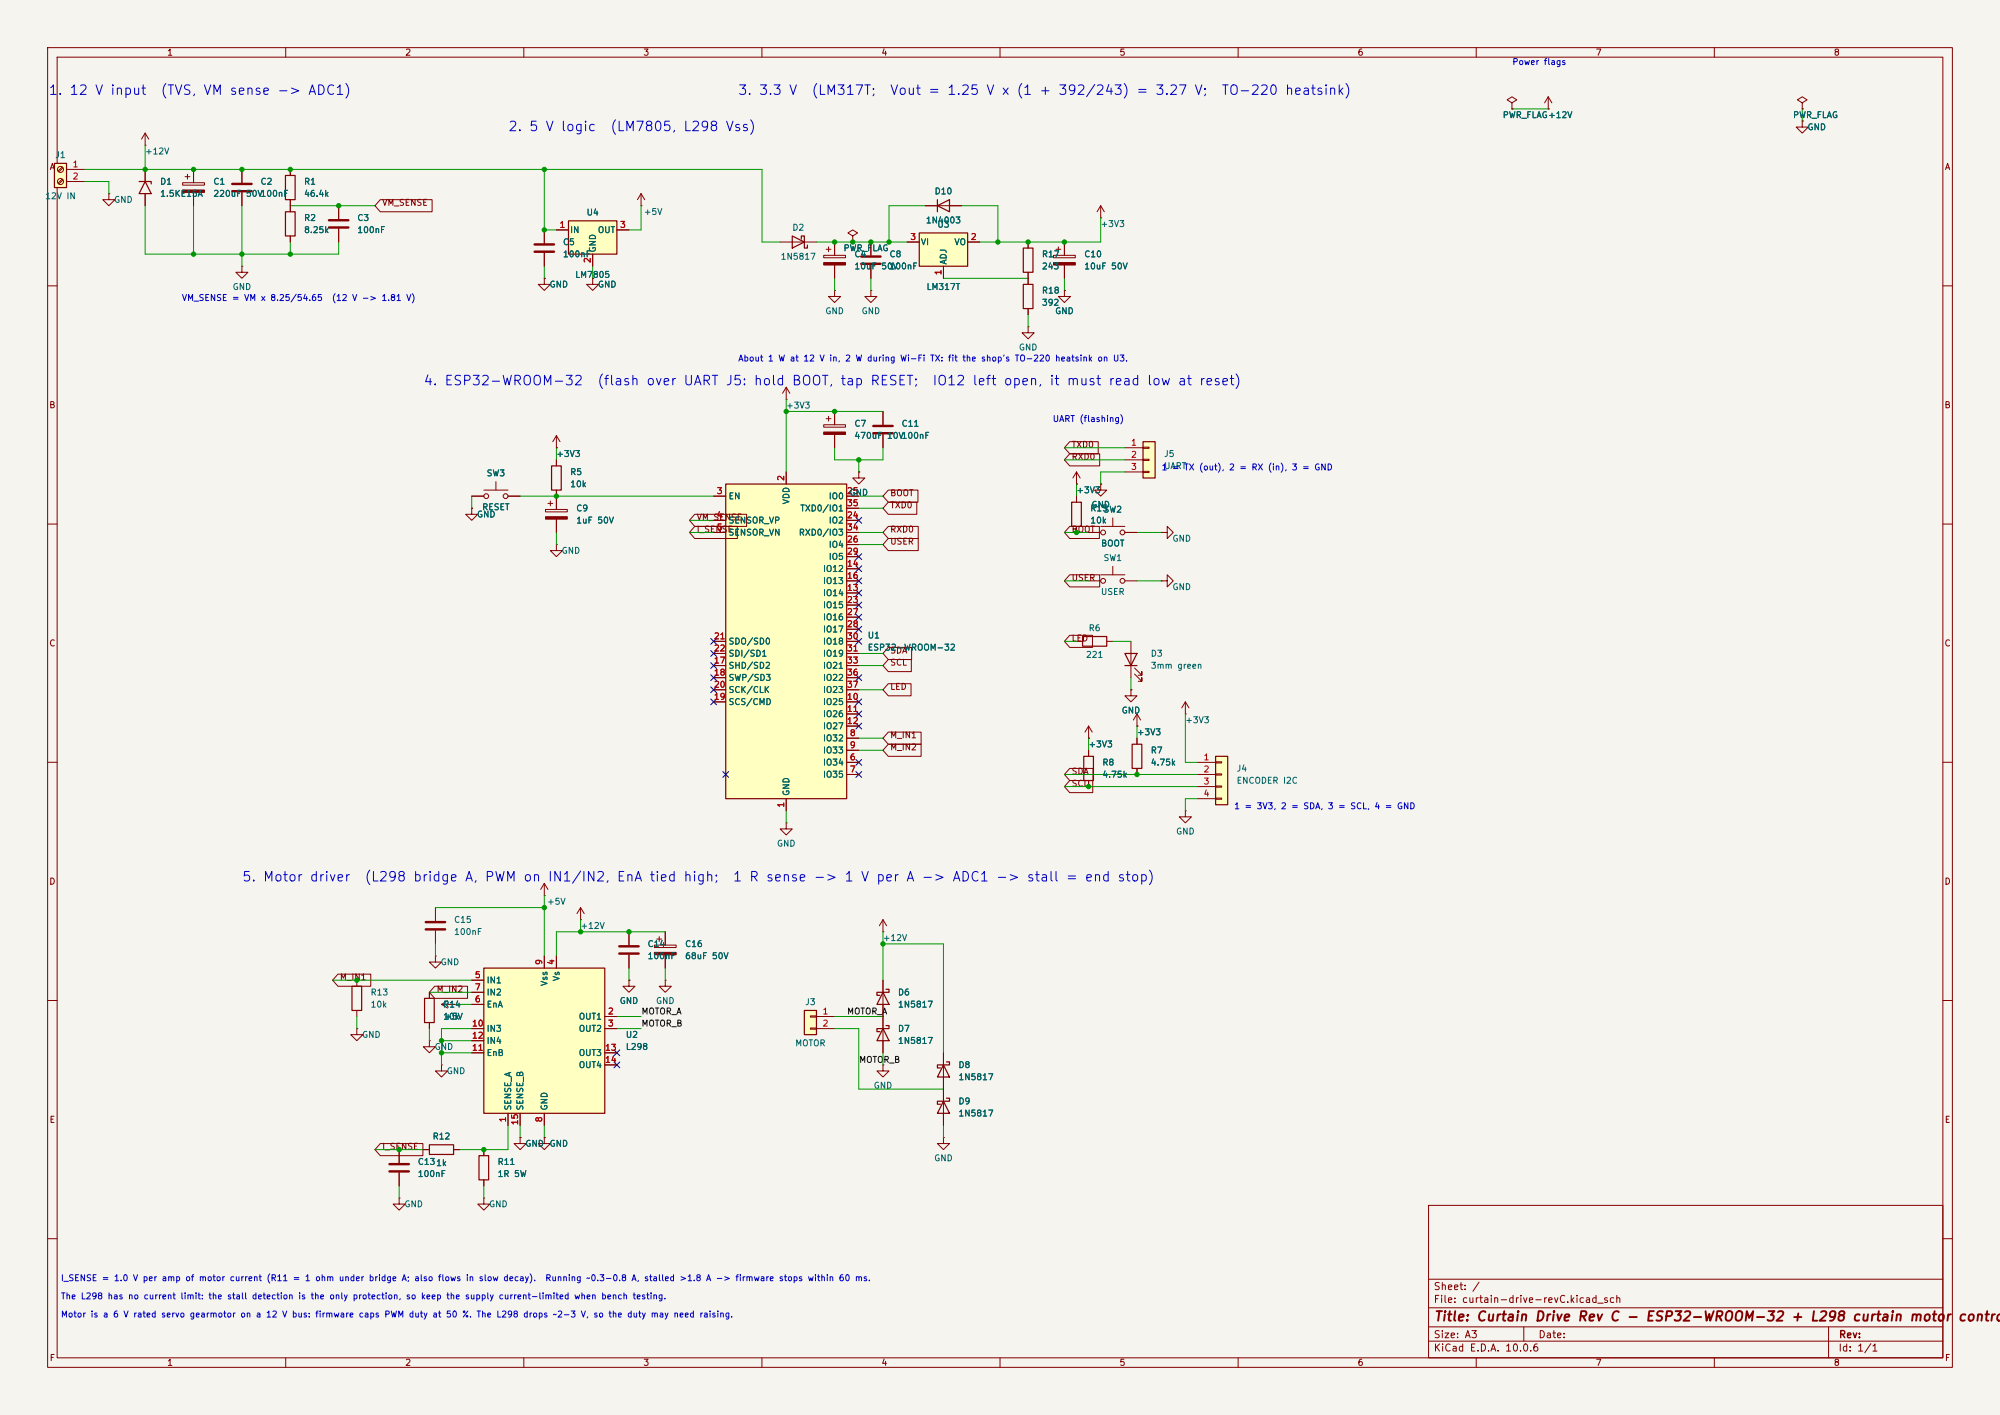
[picture p58: page 1]

1. 12 V input (TVS, VM sense -> ADC1)

About 1 W at 12 V in, 2 W during Wi-Fi TX: fit the shop's TO-220 heatsink on U3. 2. 5 V logic (LM7805, L298 Vss)

4. ESP32-WROOM-32 (flash over UART J5: hold BOOT, tap RESET; IO12 left open, it must read low at reset)

1 = TX (out), 2 = RX (in), 3 = GND

5. Motor driver (L298 bridge A, PWM on IN1/IN2, EnA tied high; 1 R sense -> 1 V per A -> ADC1 -> stall = end stop)

I_SENSE = 1.0 V per amp of motor current (R11 = 1 ohm under bridge A; also flows in slow decay). Running ~0.3-0.8 A, stalled >1.8 A -> firmware stops within 60 ms.

Sheet: /
File: curtain-drive-revC.kicad_sch
Title: Curtain Drive Rev C - ESP32-WROOM-32 + L298 curtain motor controller (THT)

Size: A3 | Rev: | F Date:
KiCad E.D.A. 10.0.6 | Id: 1/1
