MadsRudolph/curtain-drive/hardware/docs/curtain-drive.pdf

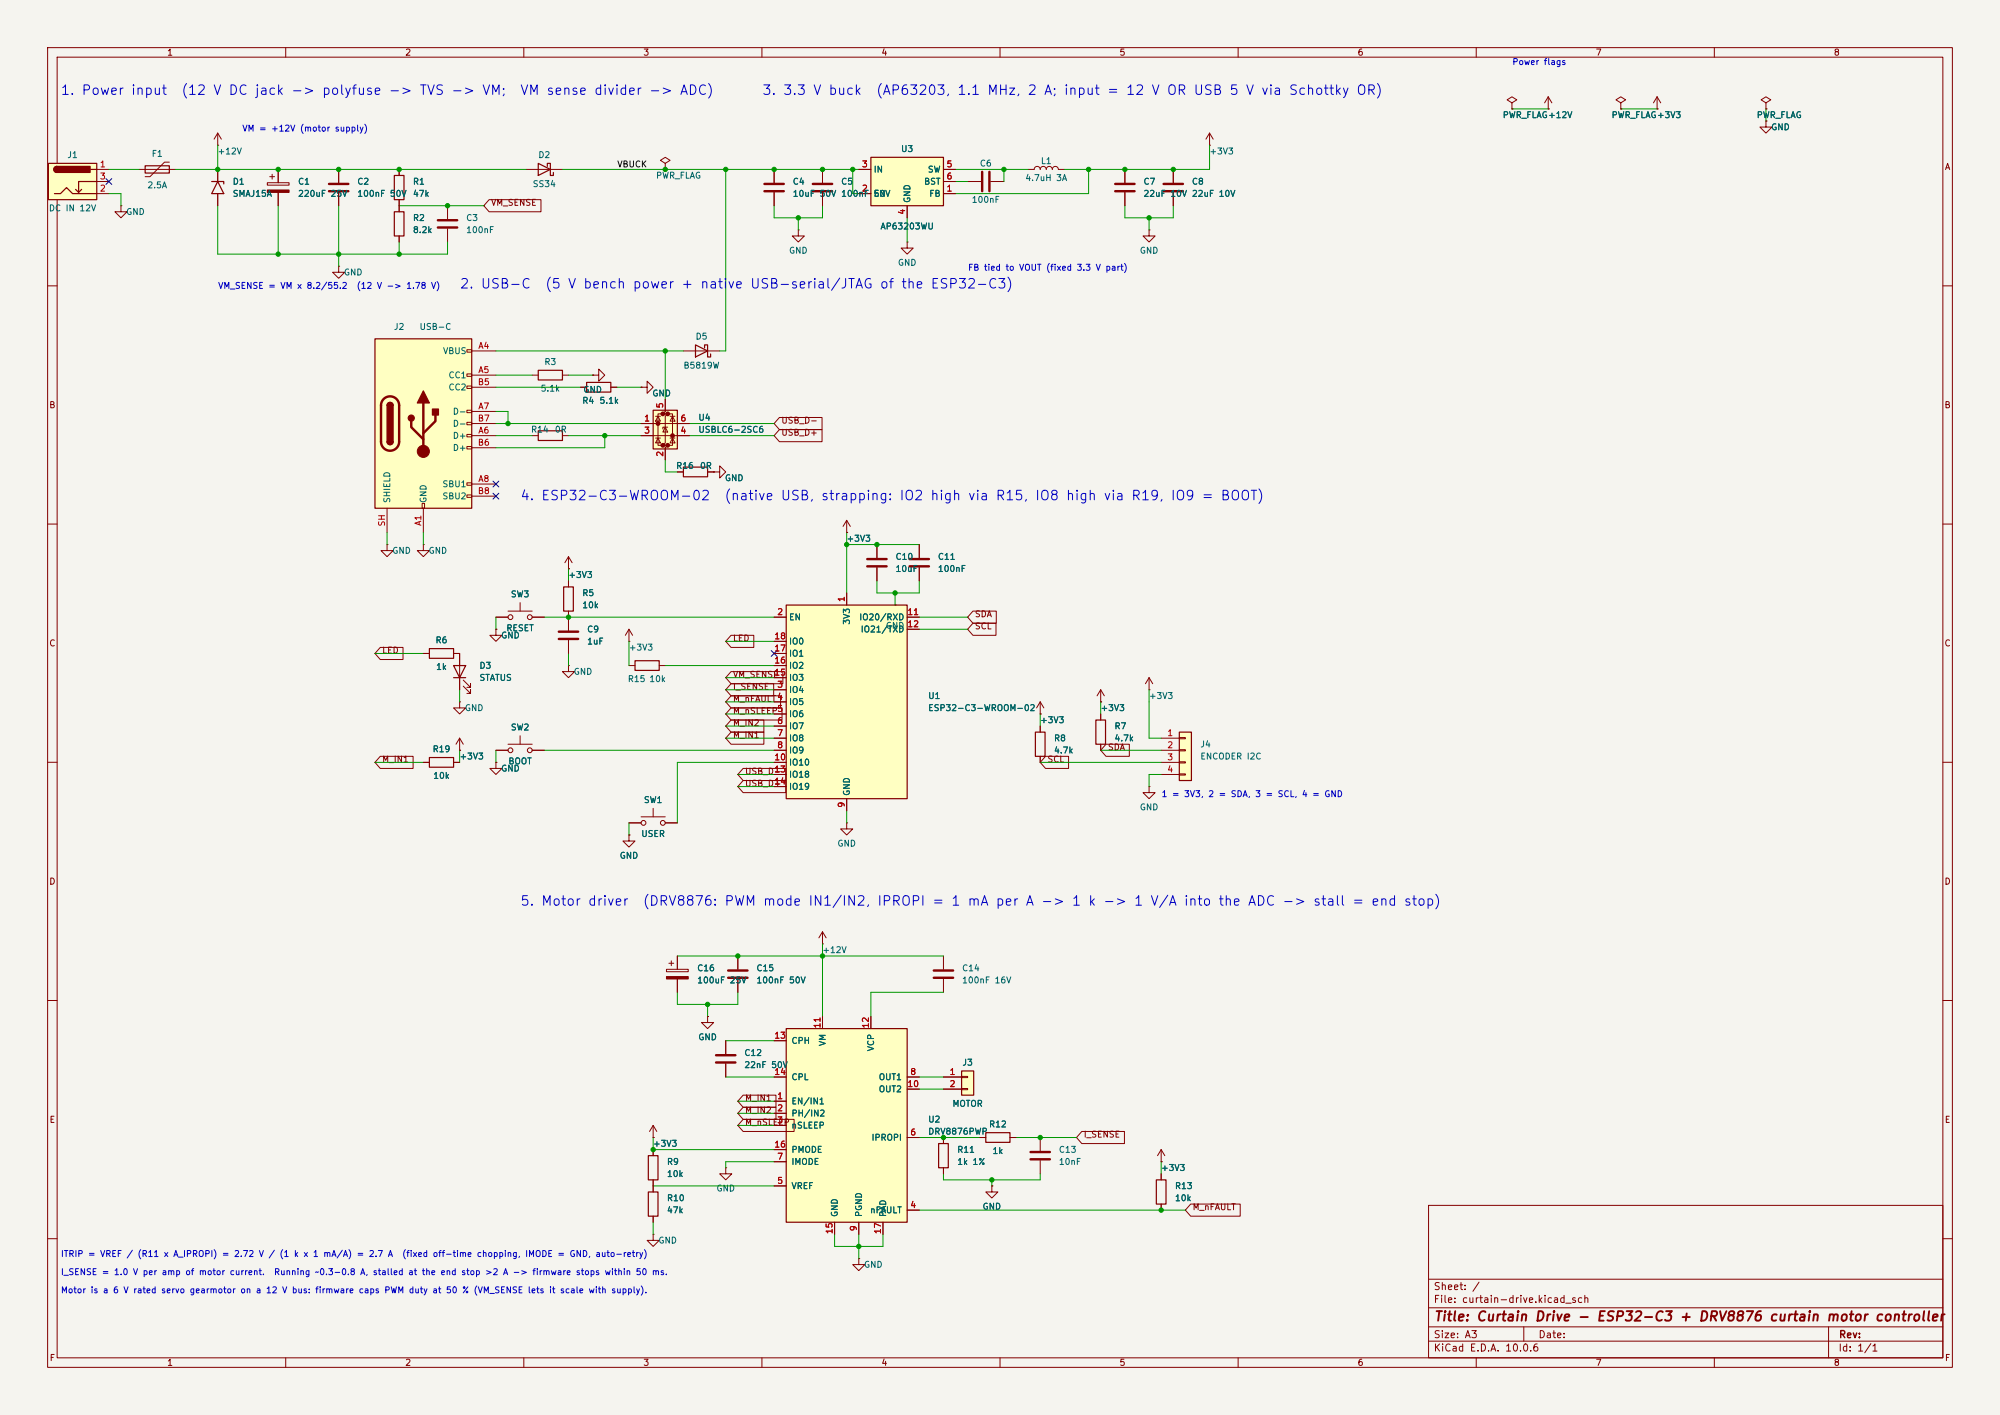
[picture p59: page 1]

1. Power input (12 V DC jack -> polyfuse -> TVS -> VM; VM sense divider -> ADC)

3. 3.3 V buck (AP63203, 1.1 MHz, 2 A; input = 12 V OR USB 5 V via Schottky OR)

VBUCK 2. USB-C (5 V bench power + native USB-serial/JTAG of the ESP32-C3)

FB tied to VOUT (fixed 3.3 V part)

4. ESP32-C3-WROOM-02 (native USB, strapping: IO2 high via R15, IO8 high via R19, IO9 = BOOT)

I_SENSE = 1.0 V per amp of motor current. Running ~0.3-0.8 A, stalled at the end stop >2 A -> firmware stops within 50 ms. 5. Motor driver (DRV8876: PWM mode IN1/IN2, IPROPI = 1 mA per A -> 1 k -> 1 V/A into the ADC -> stall = end stop)

9 OUT2 10 VM 11 VCP 12 CPH 13 CPL 14 GND 15 PMODE 16 PAD 17 U2DRV8876PWP

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

ITRIP = VREF / (R11 x A_IPROPI) = 2.72 V / (1 k x 1 mA/A) = 2.7 A (fixed off-time chopping, IMODE = GND, auto-retry)

Sheet: /
File: curtain-drive.kicad_sch
Title: Curtain Drive - ESP32-C3 + DRV8876 curtain motor controller

Motor is a 6 V rated servo gearmotor on a 12 V bus: firmware caps PWM duty at 50 % (VM_SENSE lets it scale with supply).

Size: A3 | Rev: | F Date:
KiCad E.D.A. 10.0.6 | Id: 1/1
