MadsRudolph/curtain-drive/hardware-revC/curtain-drive-revC.kicad_pcb

## KiCad design hardware-revC/curtain-drive-revC.kicad_pcb (2026-09-26)

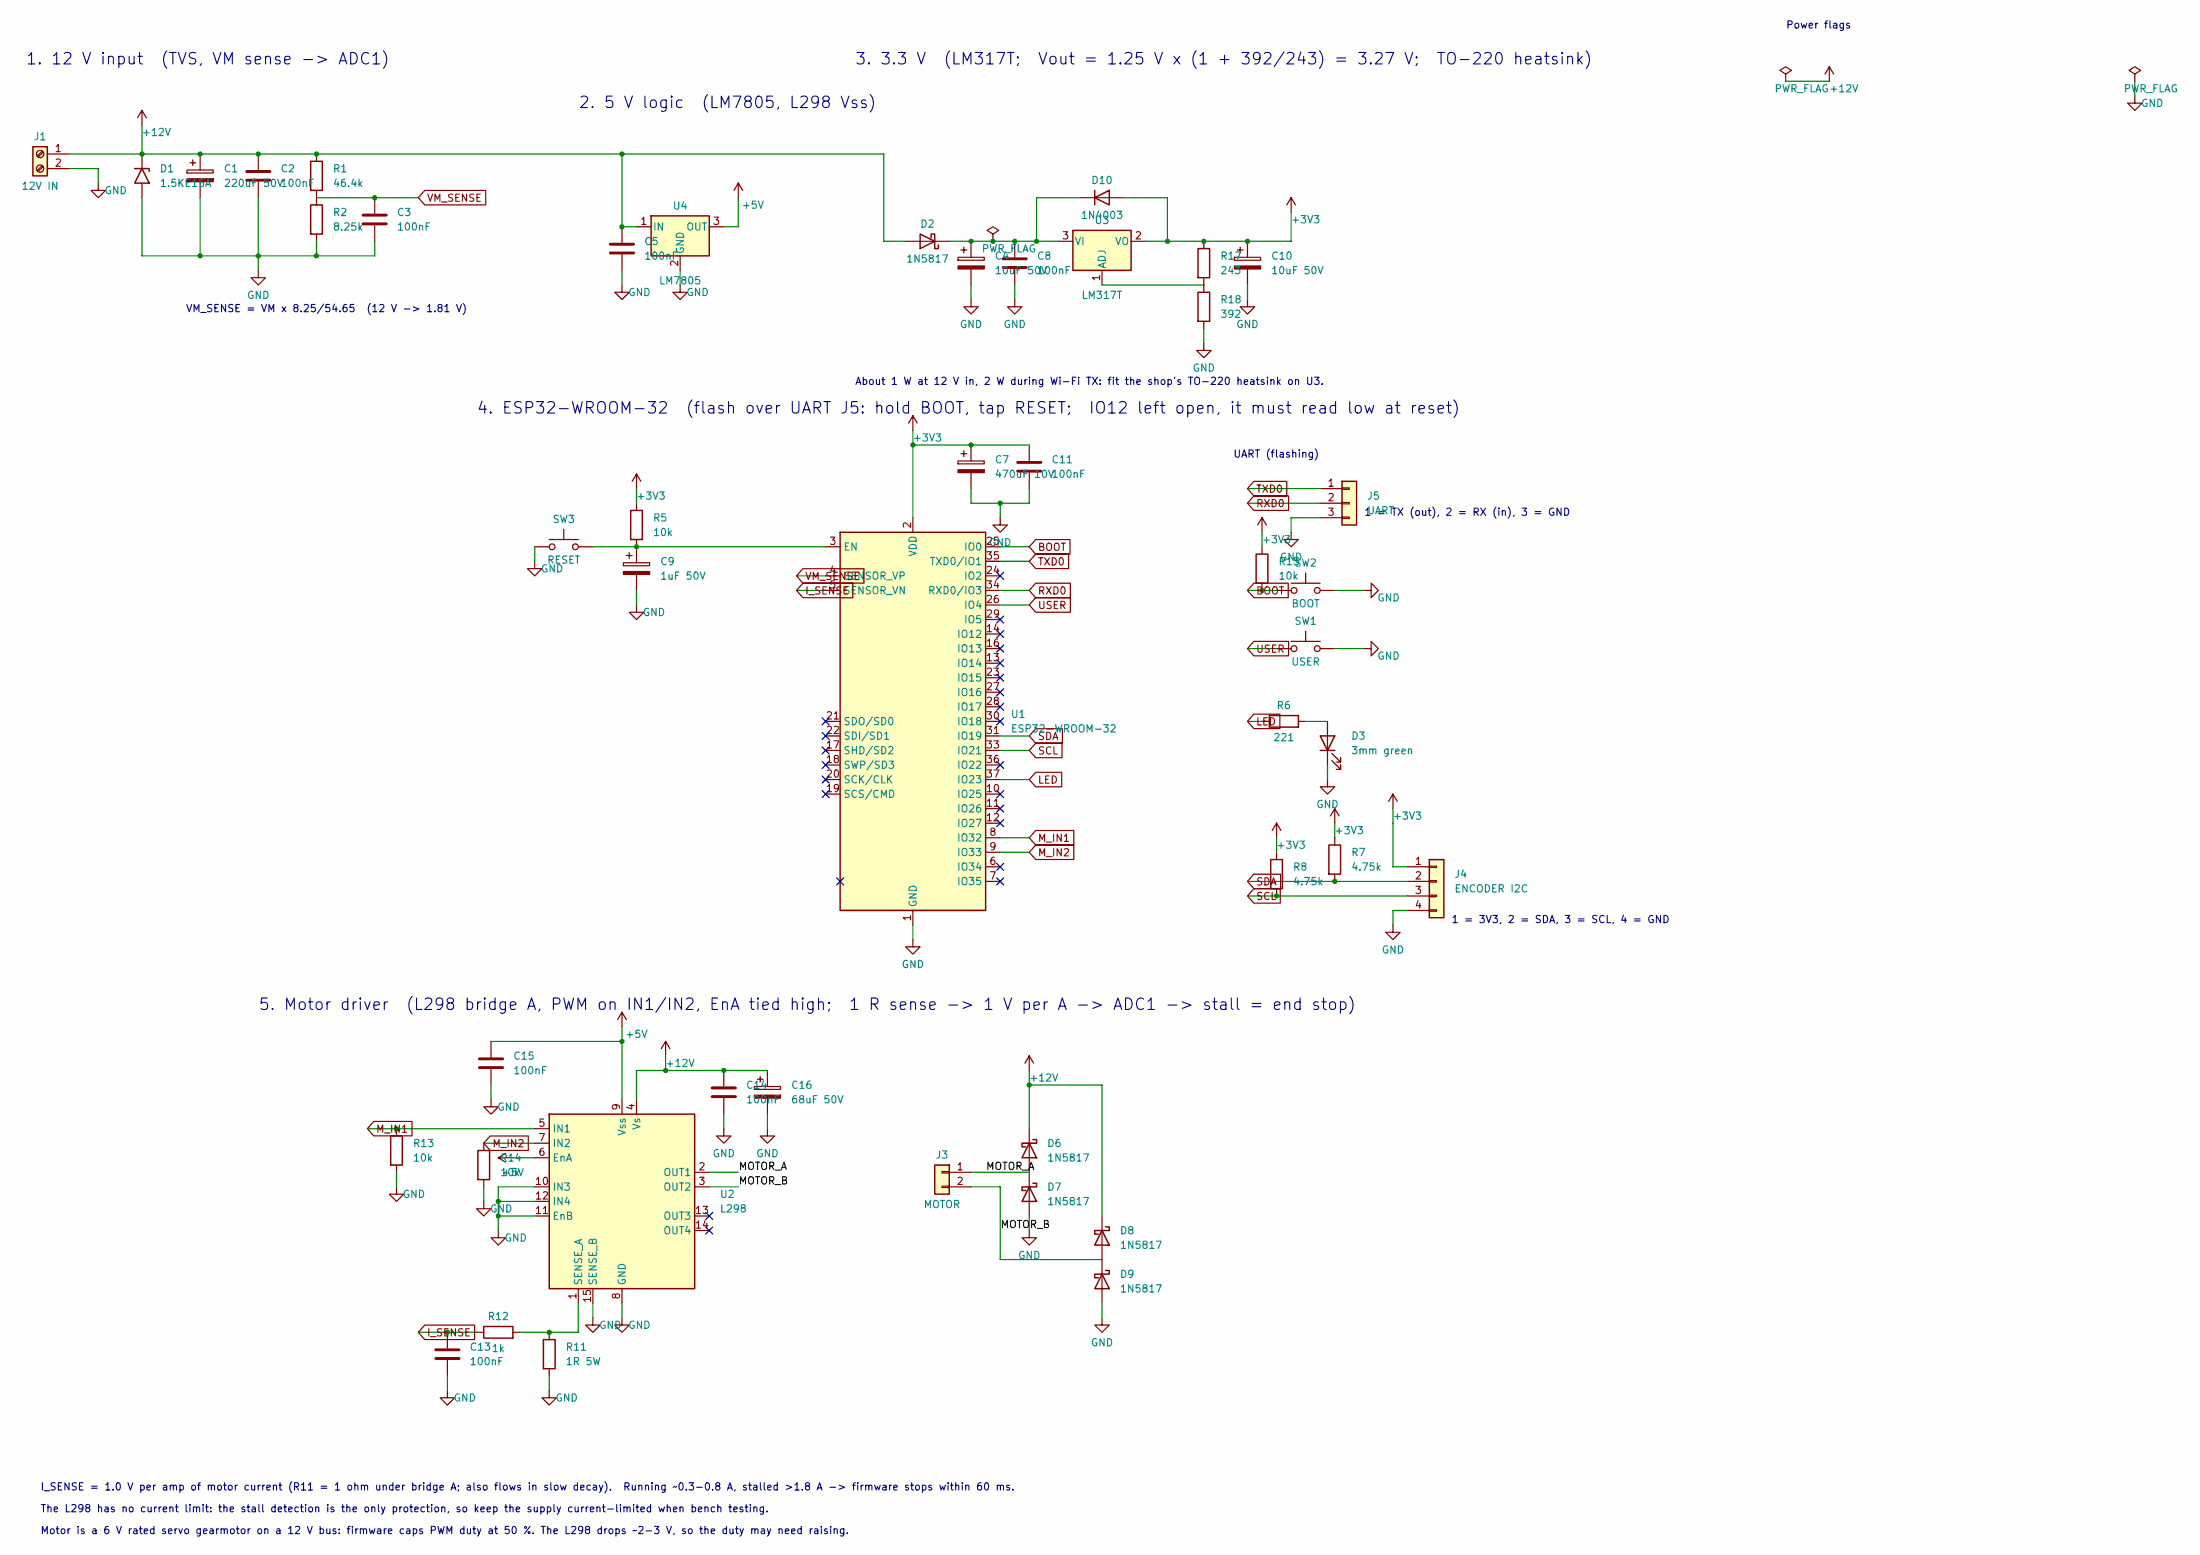
[picture p60: schematic curtain-drive-revC.kicad_sch, Curtain Drive Rev C - ESP32-WROOM-32 + L298 curtain motor c…]

Parts:
C1: 220uF 50V; CP_Radial_D10.0mm_P5.00mm
C2, C3, C5, C8, C11, C13, C15: 100nF; C_Disc_D5.0mm_W2.5mm_P5.00mm
C4, C10: 10uF 50V; CP_Radial_D5.0mm_P2.00mm
C7: 470uF 10V; CP_Radial_D8.0mm_P3.50mm
C9: 1uF 50V; CP_Radial_D5.0mm_P2.00mm
C14: 100nF; C_Disc_D5.0mm_W2.5mm_P7.62mm_Bent
C16: 68uF 50V; CP_Radial_D8.0mm_P3.50mm
D1: 1.5KE15A; D_DO-201AE_P15.24mm_Horizontal
D2, D6, D7, D8, D9: 1N5817; D_DO-41_SOD81_P10.16mm_Horizontal
D3: 3mm green; LED_D3.0mm
D10: 1N4003; D_DO-41_SOD81_P10.16mm_Horizontal
J1: 12V IN; TerminalBlock_Phoenix_MKDS-1,5-2-5.08_1x02_P5.08mm_Horizont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
J3: MOTOR; Molex_KK-254_AE-6410-02A_1x02_P2.54mm_Vertical
J4: ENCODER I2C; Molex_KK-254_AE-6410-04A_1x04_P2.54mm_Vertical
J5: UART; PinHeader_1x03_P2.54mm_Vertical
R1: 46.4k; R_Axial_DIN0207_L6.3mm_D2.5mm_P7.62mm_Horizontal
R2: 8.25k; R_Axial_DIN0207_L6.3mm_D2.5mm_P7.62mm_Horizontal
R5, R13, R14, R15: 10k; R_Axial_DIN0207_L6.3mm_D2.5mm_P7.62mm_Horizontal
R6: 221; R_Axial_DIN0207_L6.3mm_D2.5mm_P7.62mm_Horizontal
R7, R8: 4.75k; R_Axial_DIN0207_L6.3mm_D2.5mm_P7.62mm_Horizontal
R11: 1R 5W; R_Axial_Power_L25.0mm_W9.0mm_P27.94mm
R12: 1k; R_Axial_DIN0207_L6.3mm_D2.5mm_P7.62mm_Horizontal
R17: 243; R_Axial_DIN0207_L6.3mm_D2.5mm_P7.62mm_Horizontal
R18: 392; R_Axial_DIN0207_L6.3mm_D2.5mm_P7.62mm_Horizontal
SW1: USER; SW_PUSH_6mm_Jumpers
SW2: BOOT; SW_PUSH_6mm_Jumpers
SW3: RESET; SW_PUSH_6mm_Jumpers
U1: ESP32-WROOM-32; ESP32-WROOM-32_NoVias
U2: L298; TO-220-15_P2.54x5.08mm_StaggerOdd_Lead4.58mm_Vertical
U3: LM317T; TO-220-3_Vertical_Heatsink16x16
U4: LM7805; TO-220-3_Vertical

Connections:
+3V3: C7.1, C10.1, C11.1, D10.2 (A), J4.1, R5.1, R7.1, R8.1, R15.1, R17.1, U1.2 (VDD), U3.2 (VO)
+5V: C15.1, U2.6 (EnA), U2.9 (Vss), U4.3 (OUT)
/MOTOR_A: D6.2 (A), D7.1 (K), J3.1, U2.2 (OUT1)
/MOTOR_B: D8.2 (A), D9.1 (K), J3.2, U2.3 (OUT2)
BOOT: R15.2, SW2.1, U1.25 (IO0)
I_SENSE: C13.1, R12.1, U1.5 (SENSOR_VN)
LED: R6.1, U1.37 (IO23)
M_IN1: R13.1, U1.8 (IO32), U2.5 (IN1)
M_IN2: R14.1, U1.9 (IO33), U2.7 (IN2)
unnamed: D3.2 (A), R6.2
unnamed: C9.1, R5.2, SW3.2, U1.3 (EN)
unnamed: R11.1, R12.2, U2.1 (SENSE_A)
unnamed: R17.2, R18.1, U3.1 (ADJ)
RXD0: J5.2, U1.34 (RXD0/IO3)
SCL: J4.3, R8.2, U1.33 (IO21)
SDA: J4.2, R7.2, U1.31 (IO19)
TXD0: J5.1, U1.35 (TXD0/IO1)
USER: SW1.1, U1.26 (IO4)
VM_SENSE: C3.1, R1.2, R2.1, U1.4 (SENSOR_VP)

Notes on the sheet:
1. 12 V input (TVS, VM sense -> ADC1)
VM_SENSE = VM x 8.25/54.65 (12 V -> 1.81 V)
2. 5 V logic (LM7805, L298 Vss)
3. 3.3 V (LM317T; Vout = 1.25 V x (1 + 392/243) = 3.27 V; TO-220 heatsink)
About 1 W at 12 V in, 2 W during Wi-Fi TX: fit the shop's TO-220 heatsink on U3.
Power flags
4. ESP32-WROOM-32 (flash over UART J5: hold BOOT, tap RESET; IO12 left open, it must read low at reset)
UART (flashing)
1 = TX (out), 2 = RX (in), 3 = GND
1 = 3V3, 2 = SDA, 3 = SCL, 4 = GND
5. Motor driver (L298 bridge A, PWM on IN1/IN2, EnA tied high; 1 R sense -> 1 V per A -> ADC1 -> stall = end stop)
I_SENSE = 1.0 V per amp of motor current (R11 = 1 ohm under bridge A; also flows in slow decay). Running ~0.3-0.8 A, stalled >1.8 A -> firmware stops within 60 ms.
The L298 has no current limit: the stall detection is the only protection, so keep the supply current-limited when bench testing.
Motor is a 6 V rated servo gearmotor on a 12 V bus: firmware caps PWM duty at 50 %. The L298 drops ~2-3 V, so the duty may need raising.

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
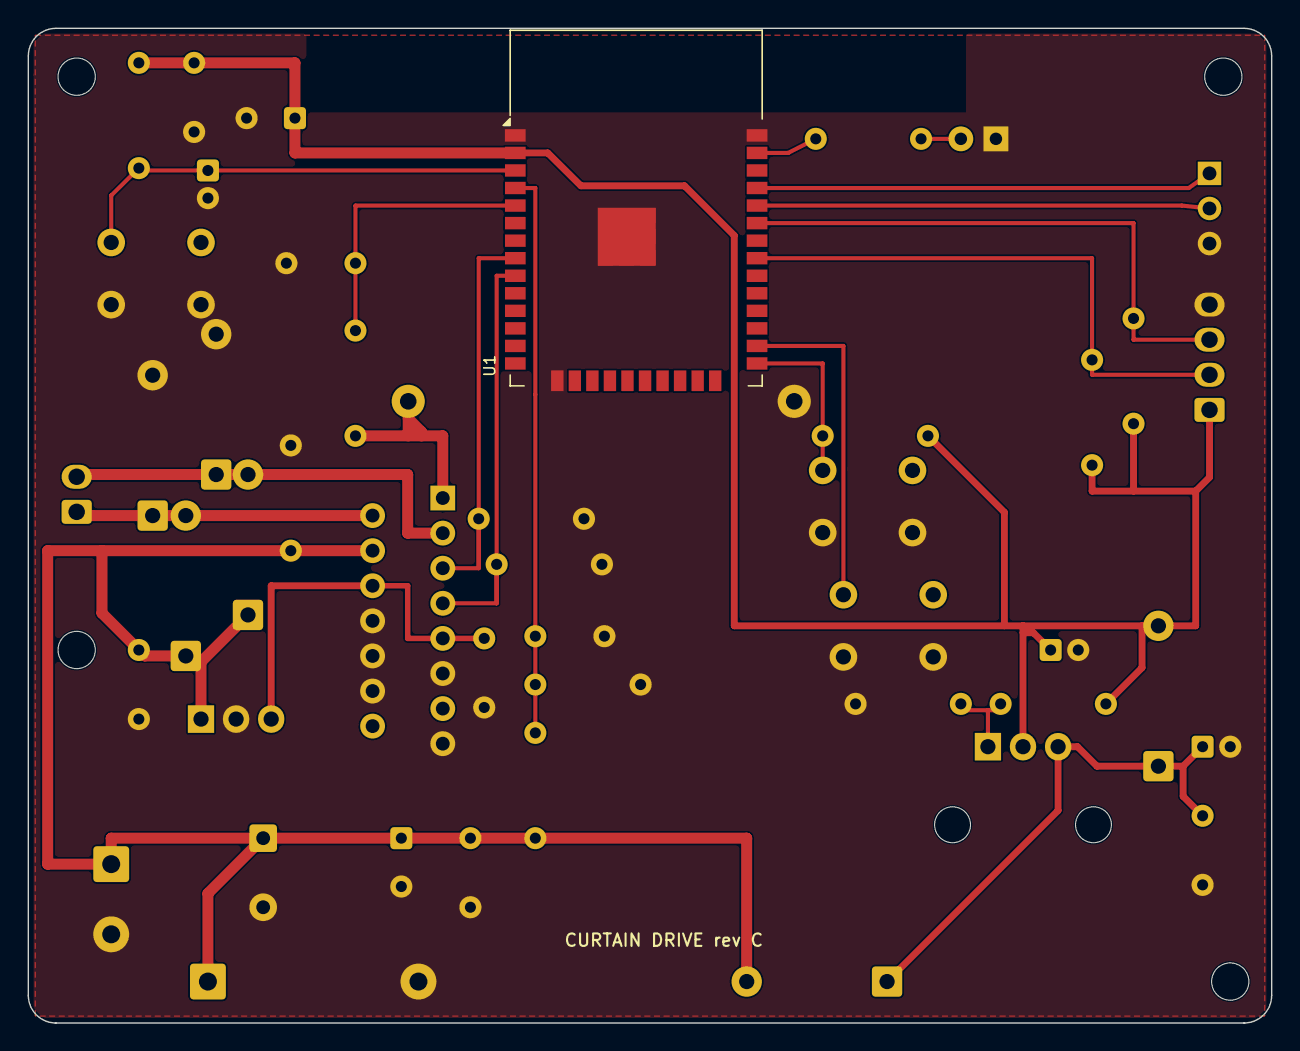
[picture p61: board curtain-drive-revC.kicad_pcb from above]

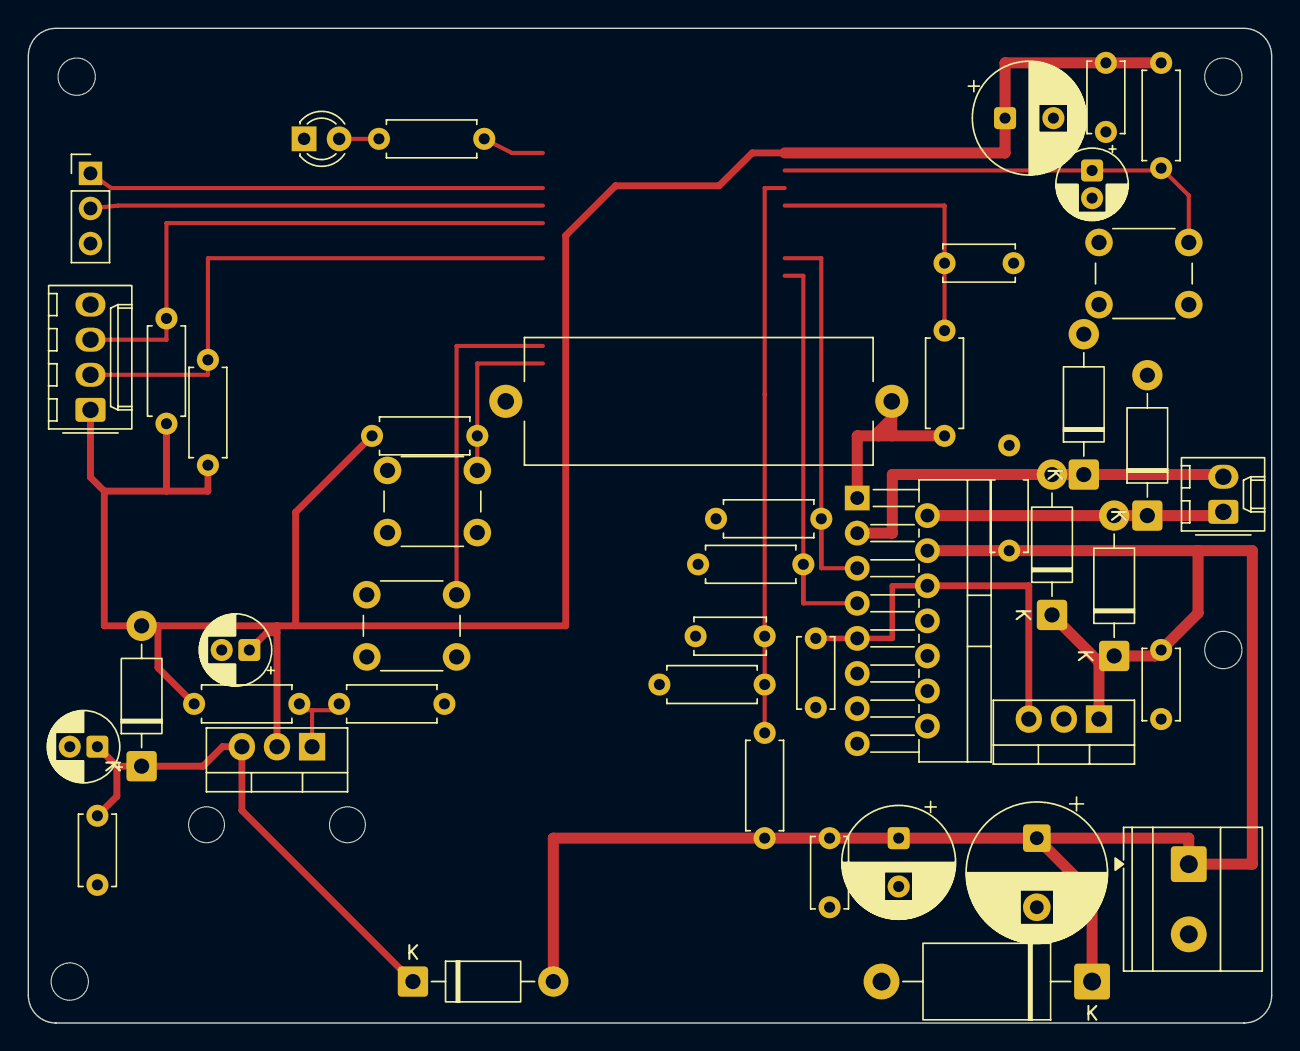
[picture p62: board curtain-drive-revC.kicad_pcb from below]

Board: 2 copper layers, 90.0 x 72.0 mm, 50 parts (45 on the bottom side), 22 nets.

Other parts of the board:
H1, H2, H3, H4: MountingHole_2.7mm_M2.5
