MadsRudolph/curtain-drive/hardware/curtain-drive.kicad_pcb

## KiCad design hardware/curtain-drive.kicad_pcb (2026-09-26)

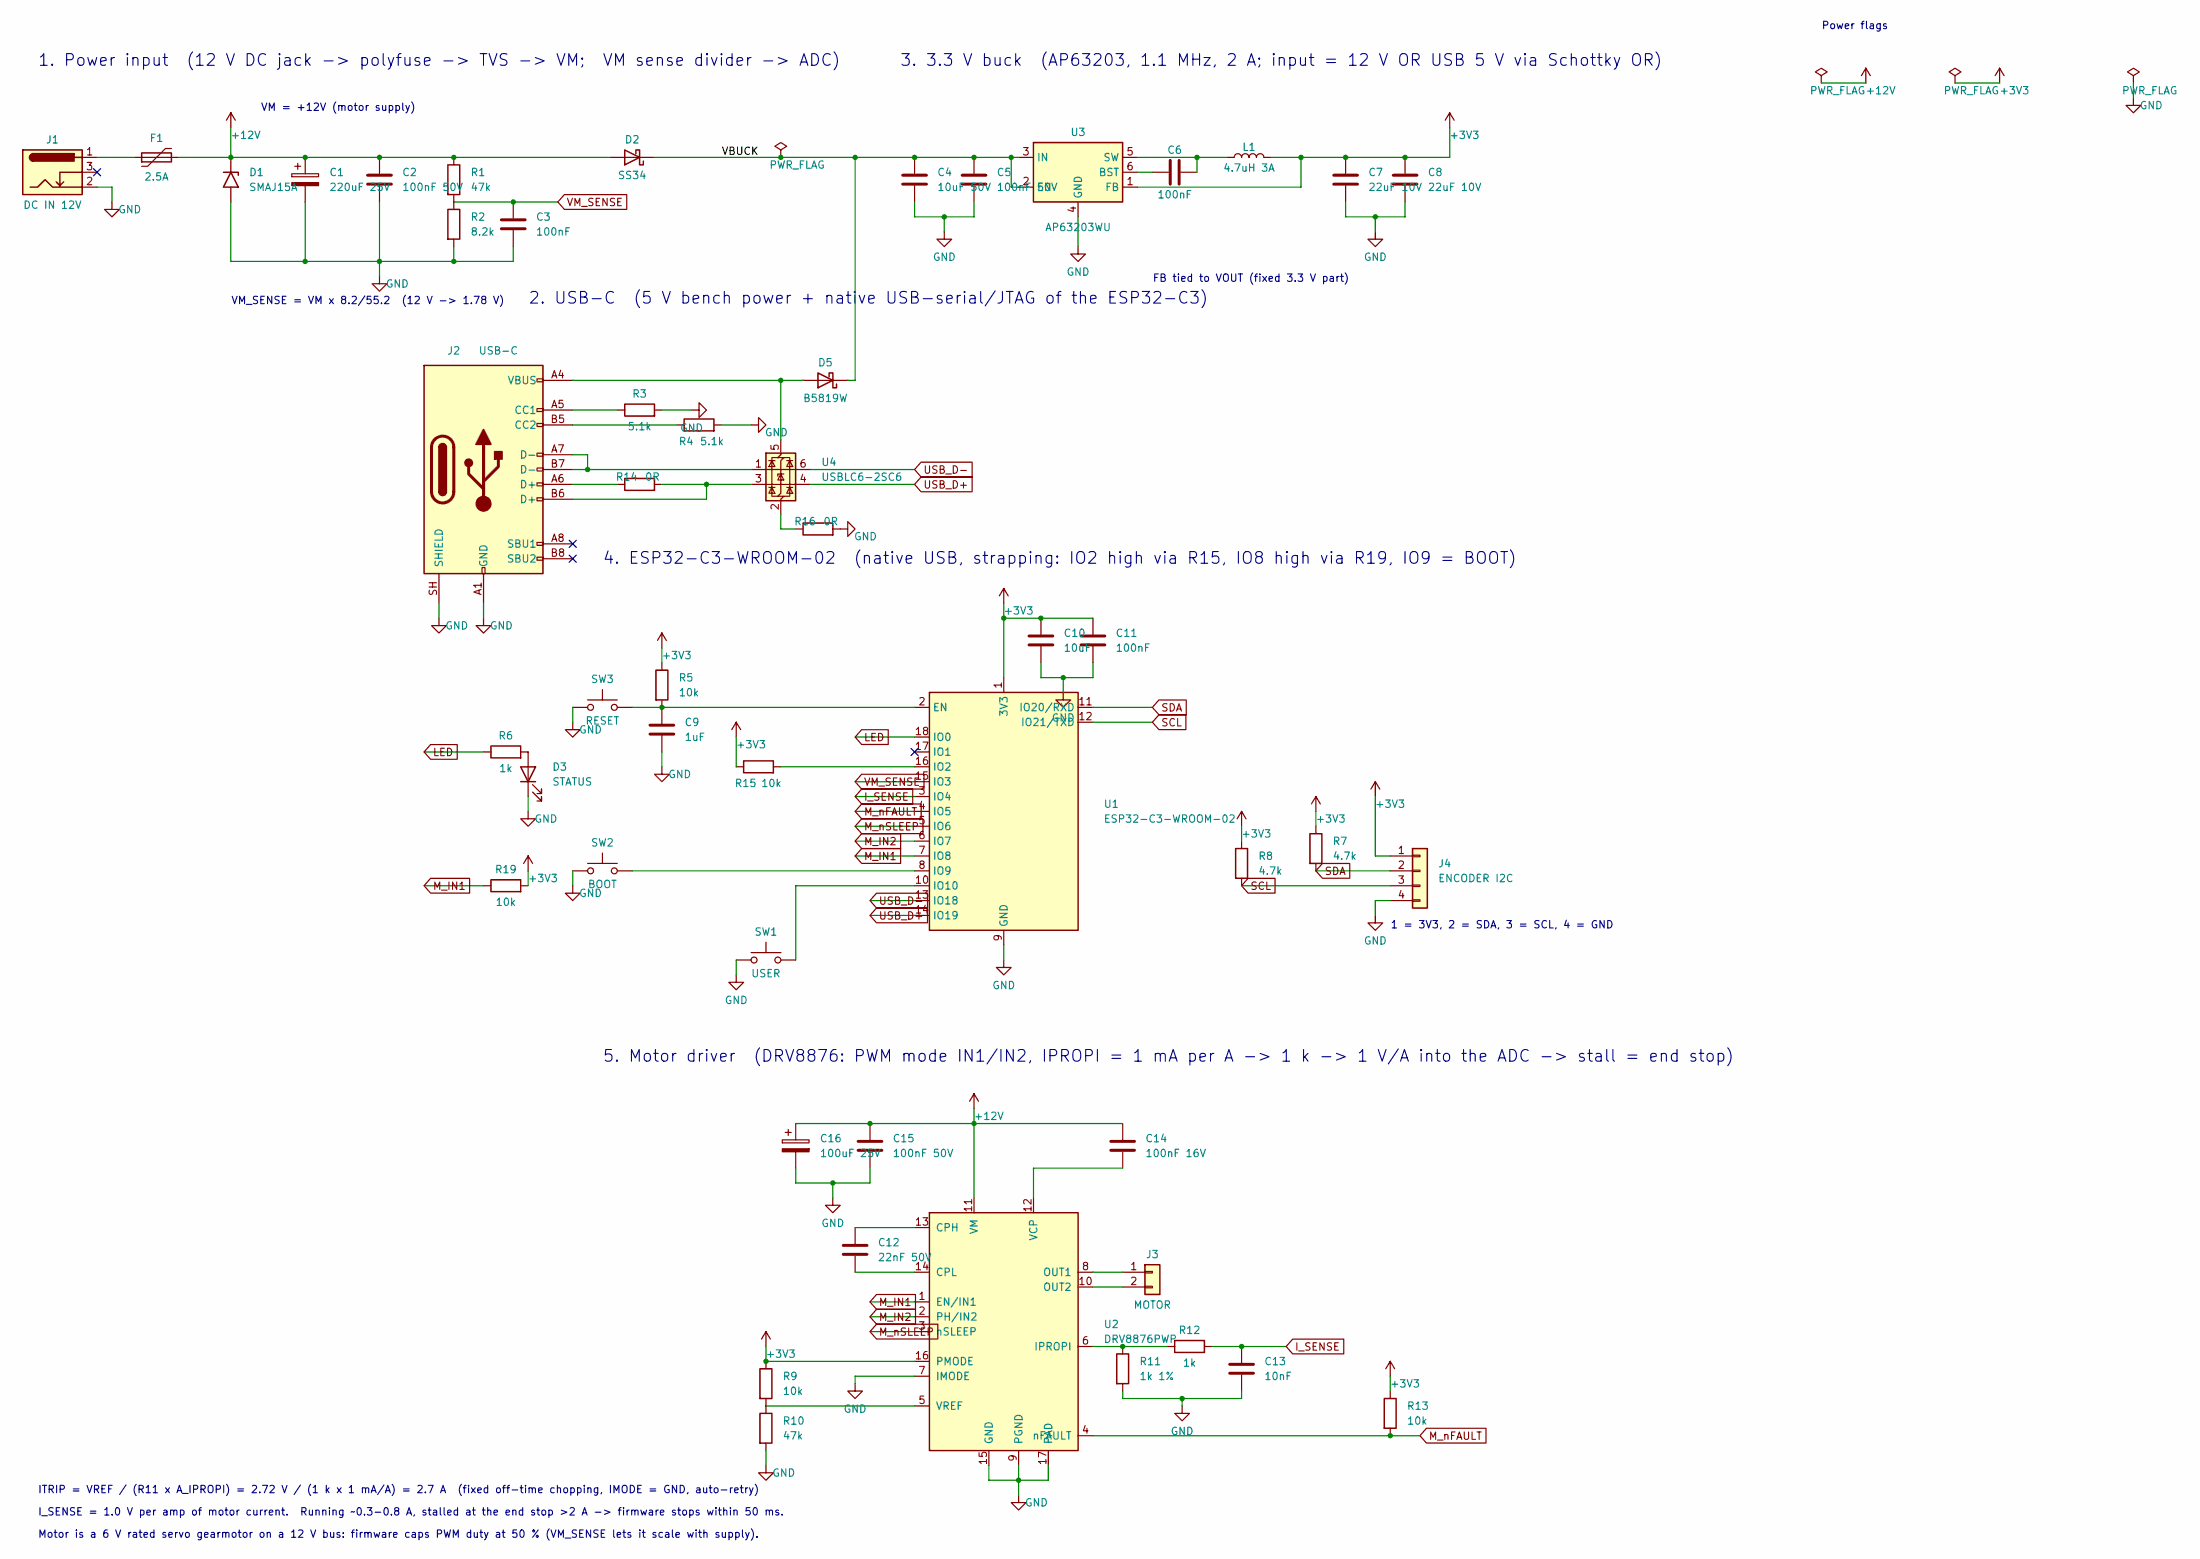
[picture p63: schematic curtain-drive.kicad_sch, Curtain Drive - ESP32-C3 + DRV8876 curtain motor controller]

Parts:
C1: 220uF 25V; CP_Elec_8x10
C2, C5, C15: 100nF 50V; C_0603_1608Metric
C3, C6, C11: 100nF; C_0603_1608Metric
C4: 10uF 50V; C_1206_3216Metric
C7, C8: 22uF 10V; C_0805_2012Metric
C9: 1uF; C_0603_1608Metric
C10: 10uF; C_0805_2012Metric
C12: 22nF 50V; C_0603_1608Metric
C13: 10nF; C_0603_1608Metric
C14: 100nF 16V; C_0603_1608Metric
C16: 100uF 25V; CP_Elec_6.3x7.7
D1: SMAJ15A; D_SMA
D2: SS34; D_SMA
D3: STATUS; LED_0603_1608Metric
D5: B5819W; D_SOD-123
F1: 2.5A; Fuse_1812_4532Metric
J1: DC IN 12V; BarrelJack_CUI_PJ-036AH-SMT_Horizontal
J2: USB-C; USB_C_Receptacle_HRO_TYPE-C-31-M-12_1L
J3: MOTOR; JST_PH_B2B-PH-SM4-TB_1x02-1MP_P2.00mm_Vertical
J4: ENCODER I2C; JST_PH_B4B-PH-SM4-TB_1x04-1MP_P2.00mm_Vertical
L1: 4.7uH 3A; L_Sunlord_MWSA0503S
R1: 47k; R_1206_3216Metric
R2: 8.2k; R_0603_1608Metric
R3: 5.1k; R_0805_2012Metric
R4: 5.1k; R_0603_1608Metric
R5, R15, R19: 10k; R_0603_1608Metric
R6, R12: 1k; R_0603_1608Metric
R7, R8: 4.7k; R_0603_1608Metric
R9, R13: 10k; R_0805_2012Metric
R10: 47k; R_0805_2012Metric
R11: 1k 1%; R_0603_1608Metric
R14: 0R; R_0603_1608Metric
R16: 0R; R_0805_2012Metric
SW1: USER; SW_SPST_PTS645Sx43SMTR92_Jumpers
SW2: BOOT; SW_SPST_PTS645Sx43SMTR92_Jumpers
SW3: RESET; SW_SPST_PTS645Sx43SMTR92_Jumpers
U1: ESP32-C3-WROOM-02; ESP32-C3-WROOM-02_NoVias
U2: DRV8876PWP; HTSSOP-16-1EP_4.4x5mm_P0.65mm_EP3.4x5mm_Mask2.46x2.31mm
U3: AP63203WU; TSOT-23-6
U4: USBLC6-2SC6; SOT-23-6

Connections:
I_SENSE: C13.1, R12.2, U1.3 (IO4)
LED: R6.1, U1.18 (IO0)
M_IN1: R19.1, U1.7 (IO8), U2.1 (EN/IN1)
M_IN2: U1.6 (IO7), U2.2 (PH/IN2)
M_nFAULT: R13.2, U1.4 (IO5), U2.4 (nFAULT)
M_nSLEEP: U1.5 (IO6), U2.3 (nSLEEP)
unnamed: D3.2 (A), R6.2
unnamed: D5.2 (A), J2.A4 (VBUS), J2.A9 (VBUS), J2.B4 (VBUS), J2.B9 (VBUS), U4.5 (VBUS)
unnamed: F1.1, J1.1
unnamed: J2.A5 (CC1), R3.1
unnamed: J2.B5 (CC2), R4.1
unnamed: J2.A6 (D+), R14.1
unnamed: J2.B6 (D+), R14.2, U4.3 (I/O2)
unnamed: J2.A7 (D-), J2.B7 (D-), U4.1 (I/O1)
unnamed: J3.1, U2.8 (OUT1)
unnamed: J3.2, U2.10 (OUT2)
unnamed: C9.1, R5.2, SW3.2, U1.2 (EN)
unnamed: R15.2, U1.16 (IO2)
unnamed: SW2.2, U1.8 (IO9)
unnamed: SW1.2, U1.10 (IO10)
unnamed: C12.1, U2.13 (CPH)
unnamed: C12.2, U2.14 (CPL)
unnamed: R11.1, R12.1, U2.6 (IPROPI)
unnamed: C14.2, U2.12 (VCP)
unnamed: R9.2, R10.1, U2.5 (VREF)
unnamed: C6.1, U3.6 (BST)
unnamed: C6.2, L1.1, U3.5 (SW)
unnamed: R16.1, U4.2 (GND)
SCL: J4.3, R8.2, U1.12 (IO21/TXD)
SDA: J4.2, R7.2, U1.11 (IO20/RXD)
USB_D+: U1.14 (IO19), U4.4 (I/O2)
USB_D-: U1.13 (IO18), U4.6 (I/O1)
VM_SENSE: C3.1, R1.2, R2.1, U1.15 (IO3)

Notes on the sheet:
1. Power input (12 V DC jack -> polyfuse -> TVS -> VM; VM sense divider -> ADC)
VM = +12V (motor supply)
VM_SENSE = VM x 8.2/55.2 (12 V -> 1.78 V)
2. USB-C (5 V bench power + native USB-serial/JTAG of the ESP32-C3)
3. 3.3 V buck (AP63203, 1.1 MHz, 2 A; input = 12 V OR USB 5 V via Schottky OR)
FB tied to VOUT (fixed 3.3 V part)
Power flags
4. ESP32-C3-WROOM-02 (native USB, strapping: IO2 high via R15, IO8 high via R19, IO9 = BOOT)
1 = 3V3, 2 = SDA, 3 = SCL, 4 = GND
5. Motor driver (DRV8876: PWM mode IN1/IN2, IPROPI = 1 mA per A -> 1 k -> 1 V/A into the ADC -> stall = end stop)
ITRIP = VREF / (R11 x A_IPROPI) = 2.72 V / (1 k x 1 mA/A) = 2.7 A (fixed off-time chopping, IMODE = GND, auto-retry)
I_SENSE = 1.0 V per amp of motor current. Running ~0.3-0.8 A, stalled at the end stop >2 A -> firmware stops within 50 ms.
Motor is a 6 V rated servo gearmotor on a 12 V bus: firmware caps PWM duty at 50 % (VM_SENSE lets it scale with supply).

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
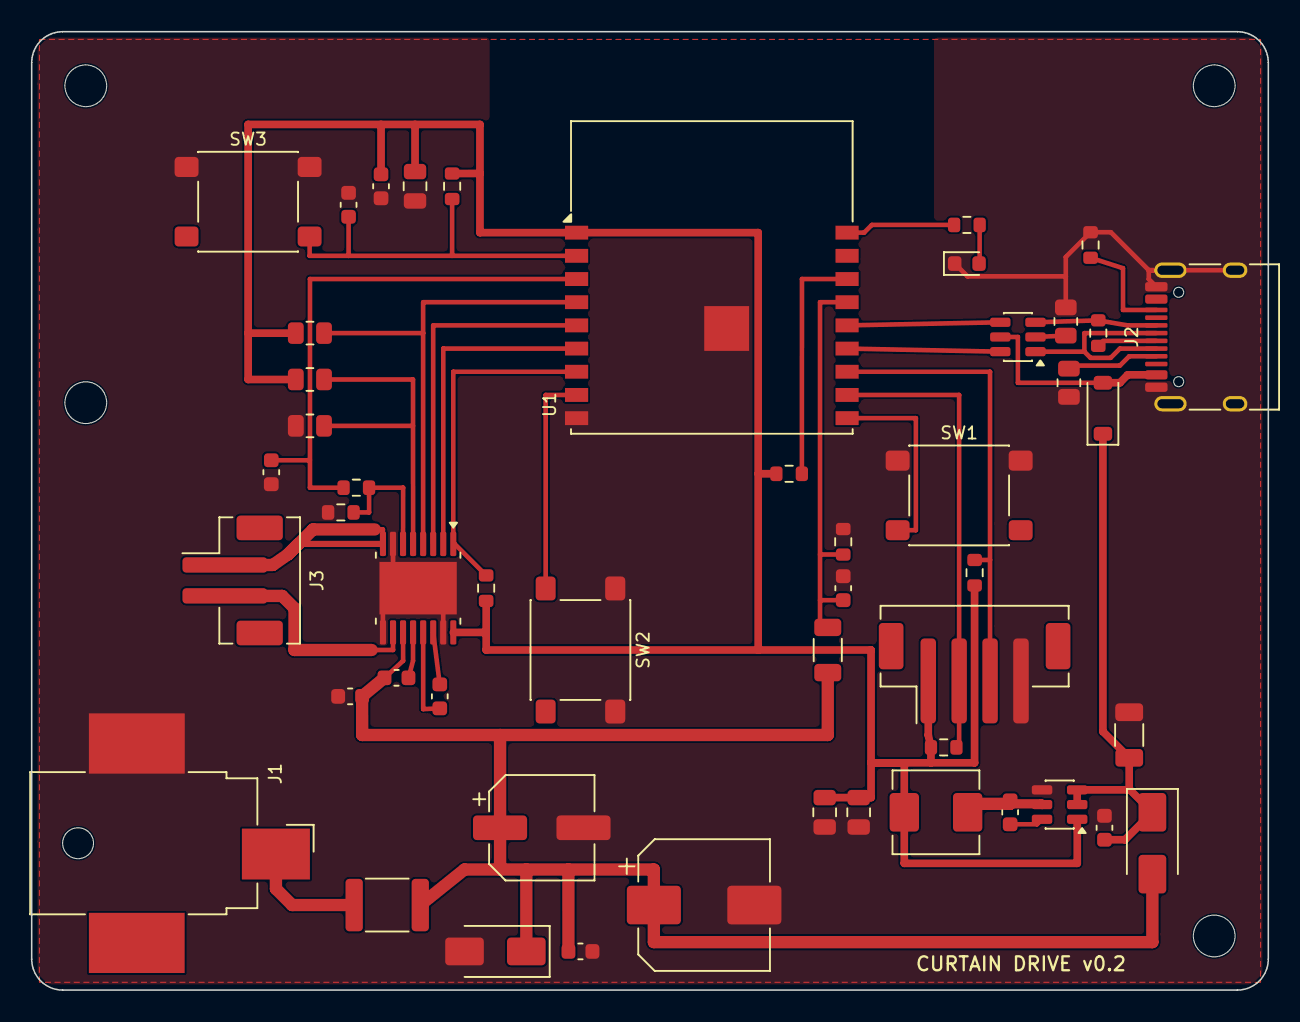
[picture p64: board curtain-drive.kicad_pcb from above]

Board: 2 copper layers, 80.0 x 62.0 mm, 54 parts (0 on the bottom side), 37 nets.

Other parts of the board:
H1, H2, H3, H4: MountingHole_2.7mm_M2.5
