MadsRudolph/curtain-drive/(commit log)

2026-09-24 Initial curtain drive hardware, firmware, enclosure
2026-09-26 Rev B through-hole board, rev A fixes, enclosure and renders
    Rev B (hardware-revB/): same circuit and ESP32-C3 as rev A, but every
    passive, diode, LED, switch and header is a through-hole part stocked by
    the DTU component shop. Still single-sided with no vias: SMD parts on
    F.Cu, THT bodies on the back. 90x72 mm, DRC clean. BOM mapped to shop
    rows in docs/revB-bom.md.
    Rev A: single-sided, via-free layout for the xTool fiber laser; D1 TVS
    turned the right way round (cathode on +12V); R8 SCL pull-up 4.7k to
    match SDA; production DXFs and drill.
    Enclosure: Blender model, 3D board exports, showcase renders and GIFs.
    Firmware: pin map for the new layout, vm_divider substitution.
2026-09-26 Laser export for the xTool F1 Ultra
    tools/laser_export.py turns a single-sided board into the files XCS
    needs: a negative (copper to ablate) and cut/drill and mask-opening
    DXFs, all as closed R12 polylines in one board-sized frame, plus a
    preview. Follows the esp32-node coupon that proved 0.15 mm gaps and
    traces; the boards stay at 0.2/0.3. Copper is F.Cu seen from above, so
    nothing is mirrored.
    Generated files for rev A and rev B, and the laser steps in the rev B
    build notes.
2026-09-26 Laser export: etch every hole into its pad as a drill mark
    Pads were exported solid, leaving nothing to drill on. The ablate file
    now removes each hole's area from its pad, like KiCad's drill-shape
    plot; --no-drill-marks keeps the old solid pads.
2026-09-26 Rev C: ESP32-WROOM-32 board, all other parts THT from the shop
    The module on hand is an ESP32-WROOM-32 (38 pads), not the ESP32-C3 rev A/B
    were drawn for, and every other part now has to be a through-hole part the
    DTU component shop stocks. That replaces the DRV8876 with an L298 (bridge A,
    four 1N5817 flyback diodes, 1 ohm sense resistor for the same 1 V/A), the
    AP63203 with an LM2575-ADJ buck plus an LM7805 for the L298 logic, and the
    barrel jack with a screw terminal. The WROOM-32 has no USB, so USB-C and its
    ESD array give way to a UART header (TX, RX, GND) for flashing with BOOT and
    RESET.
    Same 90 x 72 mm outline and mounting holes as rev B, single-sided, no vias:
    the module is the only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
2026-09-26 Rev C: per-layer DXFs out of their folders, router log untracked
    kicad-cli took each -o name for a directory. The FreeRouting log is a build
    by-product.
2026-09-26 Rev C: proven LM317 supply for the WROOM-32, 470 uF at the module
    Rework rev C to the ESP32 recipe that ran on real hardware
    (esp32-solder-test). The LM2575 buck was untested with the shop's 120 uH
    inductor; the 3.3 V rail now comes from an LM317T (243R/392R, 3.27 V) fed
    from 12 V through a 1N5817, with a 1N4003 reverse-protection diode, 10 uF +
    100 nF at its input and 10 uF at its output. It needs the shop's TO-220
    heatsink at 12 V, and its tab faces a cleared area at the bottom edge.
    The 470 uF bulk cap moves onto the module's 3V3 line, on a 0.8 mm track:
    a 10 uF rail collapsed under the Wi-Fi TX peaks on the test board. IO0
    gets its 10k pull-up (R15), and the firmware caps TX power at 8.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
2026-09-26 Rev C: pin holes and keep-out for U3's pin-mount heatsink
    The shop's TO-220 heatsink (16 x 16 x 25.4 mm) stands on two 2.3 mm pins,
    10.2 mm apart, with their centres 2.5 mm behind the face the LM317's tab
    bolts to. U3 gets its own footprint with those two 2.6 mm unplated holes
    (5.65 mm behind the leg row, centred on OUT) and a courtyard covering the
    heatsink, so the laser cut file carries the holes and no part lands under it.
    U3 moves up to y = 52 so the heatsink ends inside the board edge; R17, R18,
    D10, C10, C4 and C8 re-placed around it. Re-routed: 0 unconnected, DRC
    clean apart from silk and courtyard margins. DXFs, drill file, PDF and
    build notes regenerated.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
2026-09-28 Rev C firmware: tuning dashboard, stall end stops tuned for the servo motor
    The drive is a DM-S2000MD with its control board and pot removed, run as a
    plain gear motor on J3. It draws ~0.5 A running and ~1.5 A stalled, so the
    stall threshold drops from 1.8 A to 1.0 A.
    Stall threshold, stall samples, speed, approach speed, soft start and
    startup blanking are now number entities (restored across reboots), so
    they can be tuned live. Soft start and blanking are separate: the start
    spike (~0.75 A at 300-350 ms) comes when the ramp reaches full duty, so the
    old shared 300 ms mask ended exactly on it. Blanking defaults to 800 ms and
    always runs at least 200 ms past the ramp.
    The web server serves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
2026-09-28 Remove the rev A/B firmware
    firmware/curtain-drive.yaml (ESP32-C3 + DRV8876) is superseded by the rev C
    firmware. The two references to it now point at git history (last present
    in 260a216).
2026-09-28 Rev C enclosure: Blender build, STLs and renders
    enclosure_revC_blender.py builds the base, lid, servo and the imported rev C
    PCB model, checks fit (no lid/base/servo overlap, connector cut-outs,
    headroom under the lid) and exports the print-oriented STLs. The board sits
    copper side down on 6 mm standoffs; the servo's shaft exits the floor.
2026-09-28 Rev C BOM: enclosure notes, 12-17 V supply with a 1.5KE24A
    The 1.5KE15A on the input conducts from 14.3 V, so D1 is now a 1.5KE24A,
    which lets the board run from 12 to 17 V (the prototype is on 15 V). Notes
    what changes above 12 V: LM317 dissipation, the 20 V 1N5817s, and the
    motor duty to set on the dashboard.
2026-09-28 Cord drive for the centre-opening curtain
    A winch drum on the servo spline with two cord chambers wound in opposite
    directions, so the loop can't slip and the motor still stalls at the ends
    for the firmware's end stops. Includes the idler and its tensioning wall
    bracket, cord clamps for the two lead runners, and spline test rings.
    Parametric OpenSCAD source, STLs and renders.
2026-09-28 KiCad project files: record the top-level sheet; ignore local history
    KiCad 10 now writes top_level_sheets into the .kicad_pro, and keeps
    automatic snapshots in .history/, which stay out of the repo.
2026-10-02 Pulley: idler bracket clearances, knot pocket on the drum
    The idler did not fit the bracket: its flanges ran 2 mm into the gussets
    and the arms left only 1 mm for the two washers. The axle moves out to
    36 mm from the wall, the arms grow to 46 mm and the gap between them is
    3 mm taller than the idler.
    The top flange of the drum sits tight against the box floor, so the knot
    on the upper cord end had nowhere to go. A 5 x 3 mm pocket now takes it.
2026-10-04 Firmware: reverse switch, taught travel, hand-set ends, torque-only end stops
    Added while mounting the cord drive:
    - "Reverse direction" swaps the motor leads in software, for panels clamped
    to the other runs of the loop.
    - "Travel time" is now an editable number, and "Teach travel" opens from
    closed at full speed and saves the run time on the second press (or on
    "Mark fully open", or the stall).
    - "Mark fully open" / "Mark fully closed" stop the motor and set the
    position by hand; the dashboard has buttons for both.
    - "Stall at the ends" (default on) runs Open/Close into a stall. Those runs
    no longer slow down for the last 10 %: at 20 % duty the stalled motor drew
    less than the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
